mbeayou/Ball-and-Plate-Balancing-System/README.md

# Ball-and-Plate-Balancing-System
This is my graduation project done for the degree of Bachelor of Science in Electrical and
Electronic Engineering (specialization: Control system), it is about the modleing, design and control of a Ball and Plate Device. This device aims to stabalize a free ball on a plate and to cancel any disturbances that may destabelize the system, and to compare between the responses of different controllers (PID,MPC,LQR)

## Repository Structure
this repository contains:
* Full Arduino Code of the entire project.
* All simukation files with matlab and simulink files.
* Thesis documentation in Latex and in PDF.
* Presentation slides.
* images, video and other assits.

## mechanical and electrical form
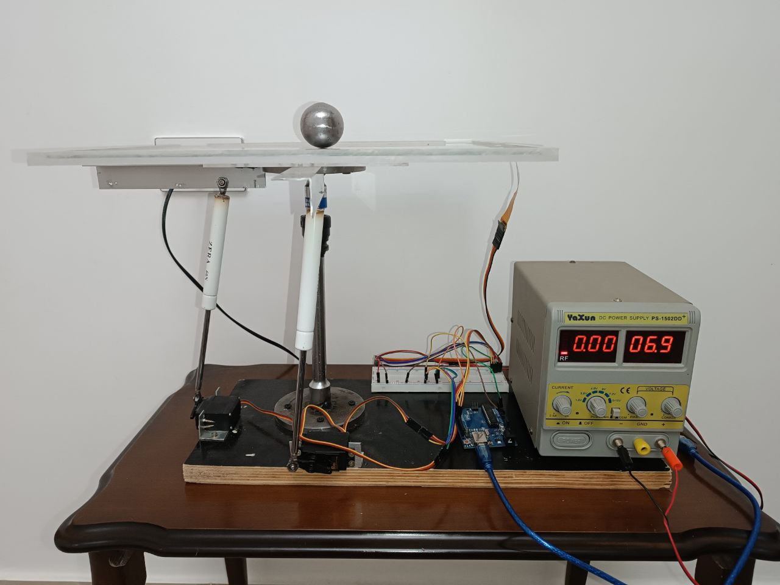
[picture p1: Assets/photo_2024-01-09_19-22-16.jpg]


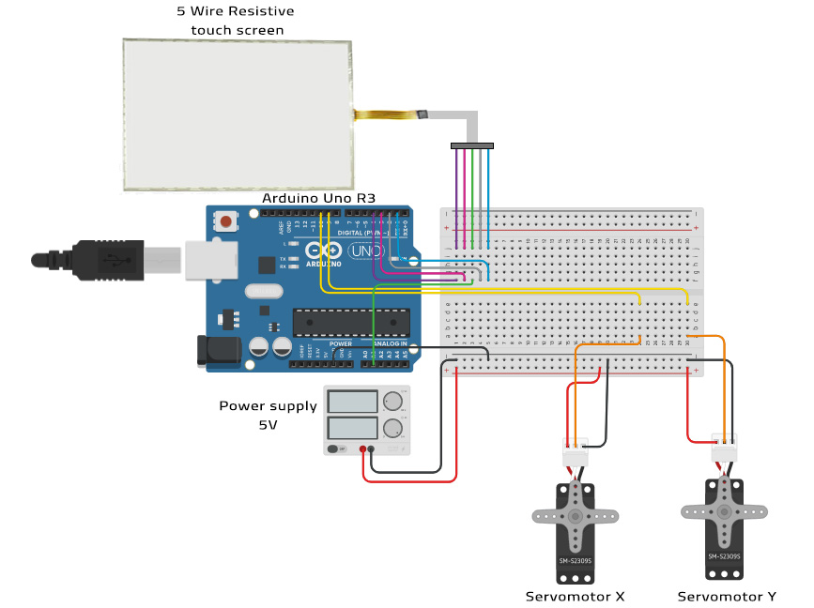
[picture p2: Documentation/Dissertation/Latex files/Figures/chapter02/Arduino_schematic.jpg]


## Acknowledgments
First of all, thanks to Allah for giving me the
ability, strength and aptitude to complete this
project.

I would like to extend my thanks and gratitude to
my supervisor Dr.Ali Elmelhi, for his advises,
suggestions, patience and encouragement
throughout this project.

I am deeply and forever obliged to thank my great
family for their love, caring, support and
encouragement throughout my entire life.

Finally, I would like to thank to all the good
friends that I have for their support and help,
with special appreciation for Mahmoud Karah
and Salman Ajweeli
