mbeayou/Ball-and-Plate-Balancing-System/Documentation/Dissertation/Latex files/titlepage.tex

\begin{titlepage}
\begin{center}
\begin{singlespace}

\vspace*{0.7cm}
\Large
Universty of Tripoli\\
Faculty of Engineering\\
Department of Electrical and Electronic Engineering \\
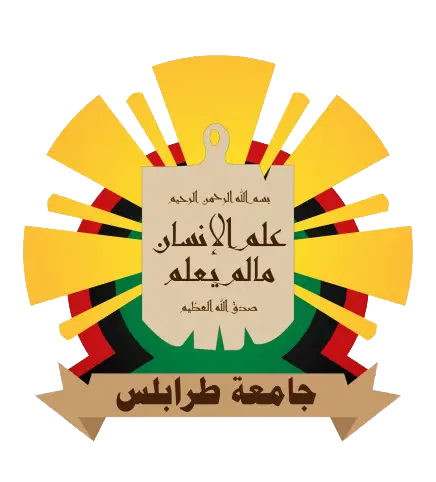
[picture p3: Documentation/Dissertation/Latex files/Figures/UOT_Logo.png]
            

\Huge
\textbf{Modeling, Control, and Experimental Validation of a Ball and Plate System}

\vspace{0.5cm}
\Large
A project submitted in partial fulfilment of the requirements for the
degree of Bachelor of Science in Electrical and Electronic Engineering

\vspace{1.2cm}
Prepared by:\\
\textbf{Mohammed S. Baayou}

\vspace{0.8cm}
Supervised by:\\
Dr. Ali S. ElMelhi
                   
\vspace{1cm}
\large
\textbf{Spring 2023}

\end{singlespace}            
\end{center}
\end{titlepage}
