mbeayou/Ball-and-Plate-Balancing-System/Documentation/Dissertation/Latex files/Chapters/appendixB.tex

\begin{figure}[h]
    \centering
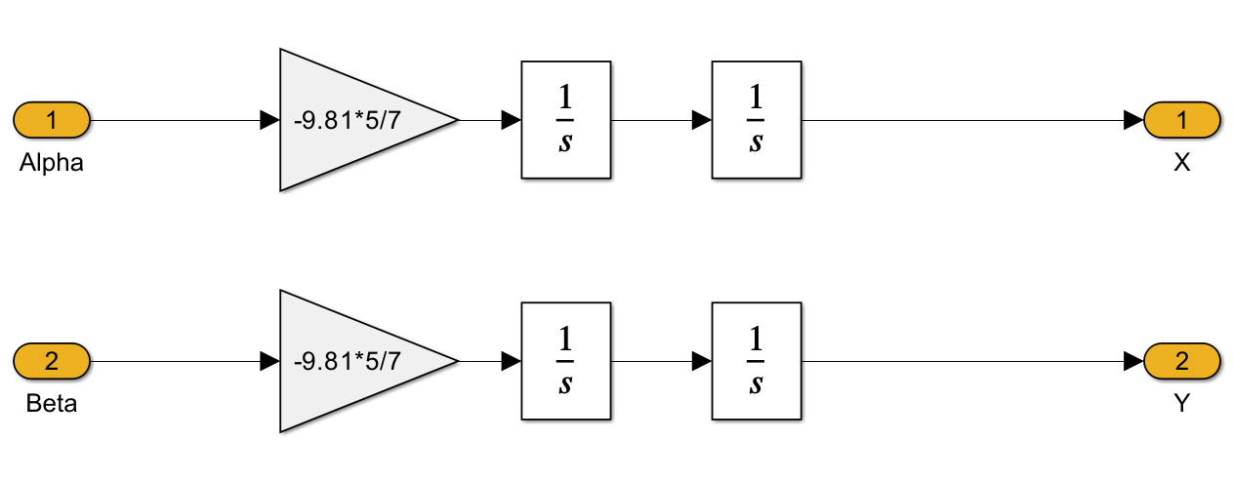
[picture p4: Documentation/Dissertation/Latex files/Figures/chapter03/Linear_BPS_Simulink_Model_inTransferFunction.jpg]
    
    \caption{Linear simulation model of the Ball and Plate System in a transfer function form}

\end{figure}
\begin{figure}
    \centering
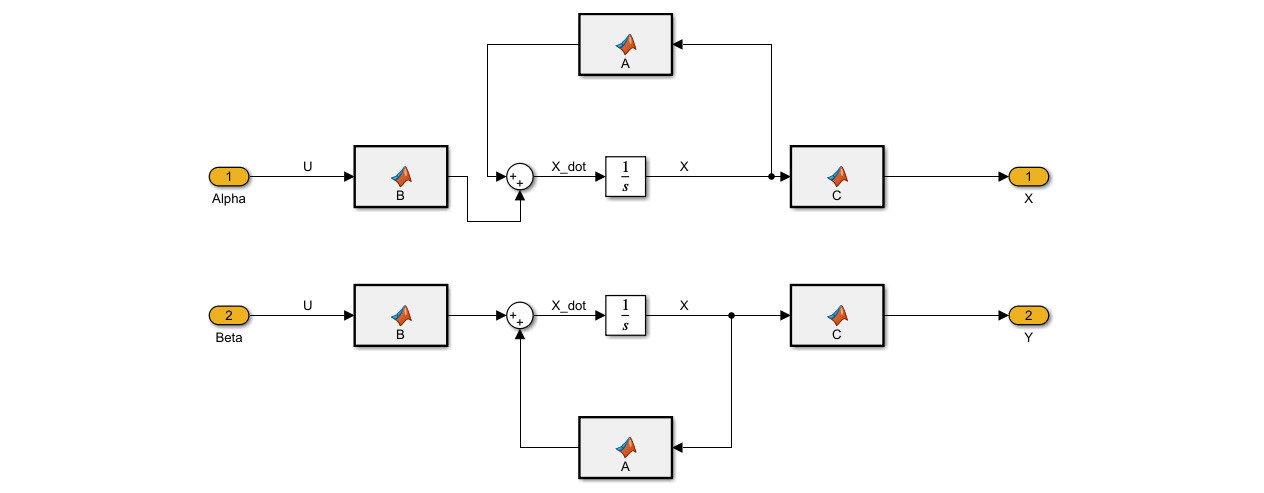
[picture p5: Documentation/Dissertation/Latex files/Figures/chapter03/Linear_BPS_Simulink_Model_inStateSpace.jpg]
    
    \caption{Linear simulation model of the Ball and Plate System in state-space form}
\end{figure}

\begin{sidewaysfigure}
\centering
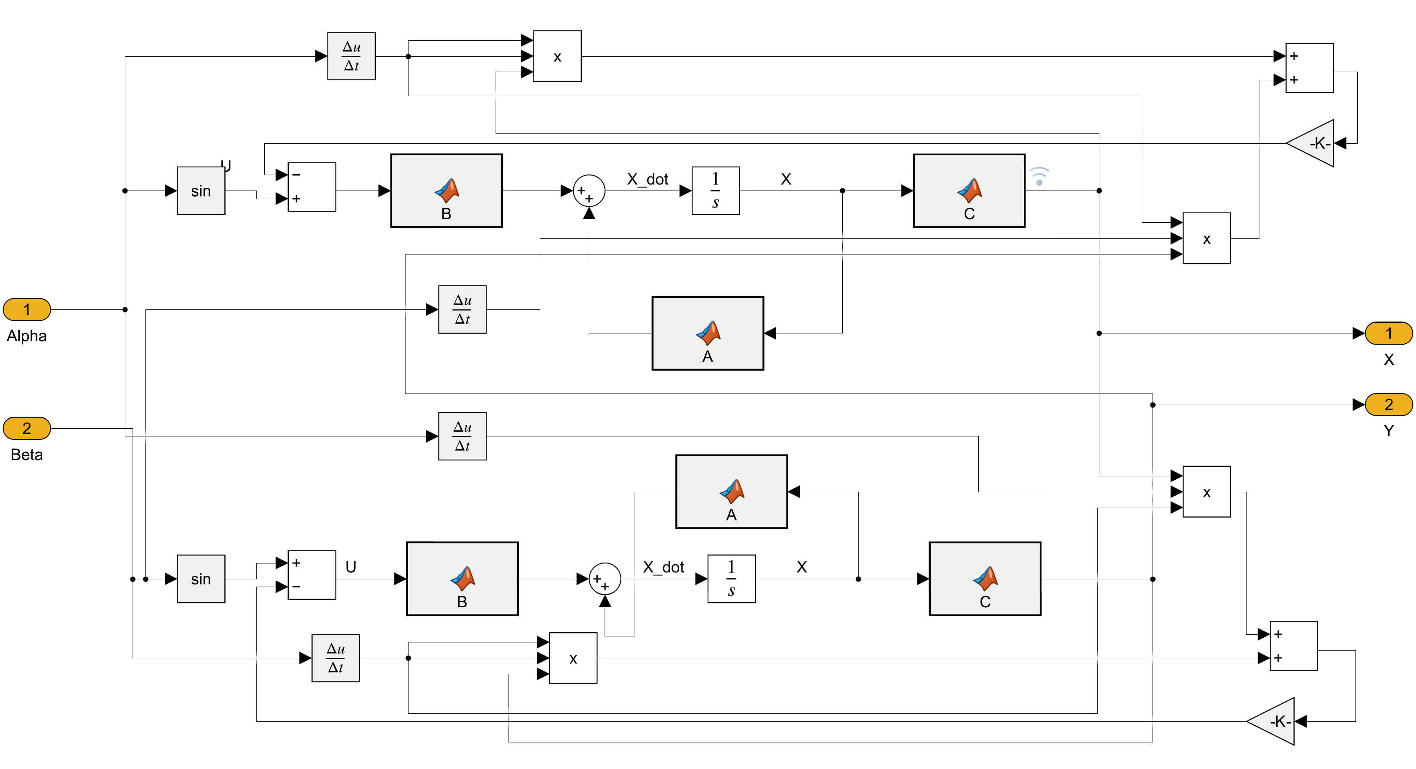
[picture p6: Documentation/Dissertation/Latex files/Figures/chapter03/nonlinear.png]

\caption{Approximated representation of the non-linear BPS dynamics in a Simulink model}
\label{fig:IMs matrix correlation}
\end{sidewaysfigure}

\begin{sidewaysfigure}
\centering
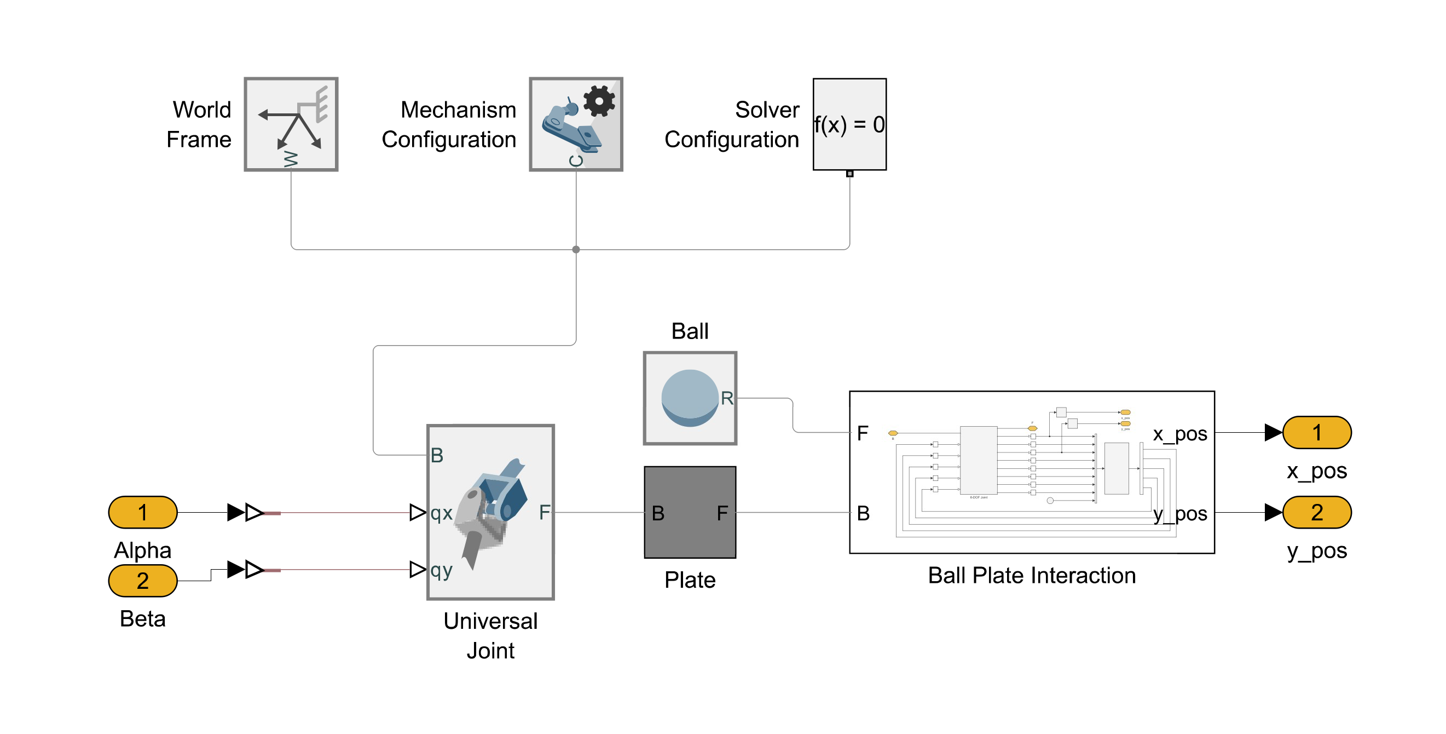
[picture p7: Documentation/Dissertation/Latex files/Figures/chapter03/simscape.png]

\caption{Dynamic simulation of the non-linear Ball and Plate System using Simscape}
\label{fig:IMs matrix correlation}
\end{sidewaysfigure}

\begin{sidewaysfigure}
\centering
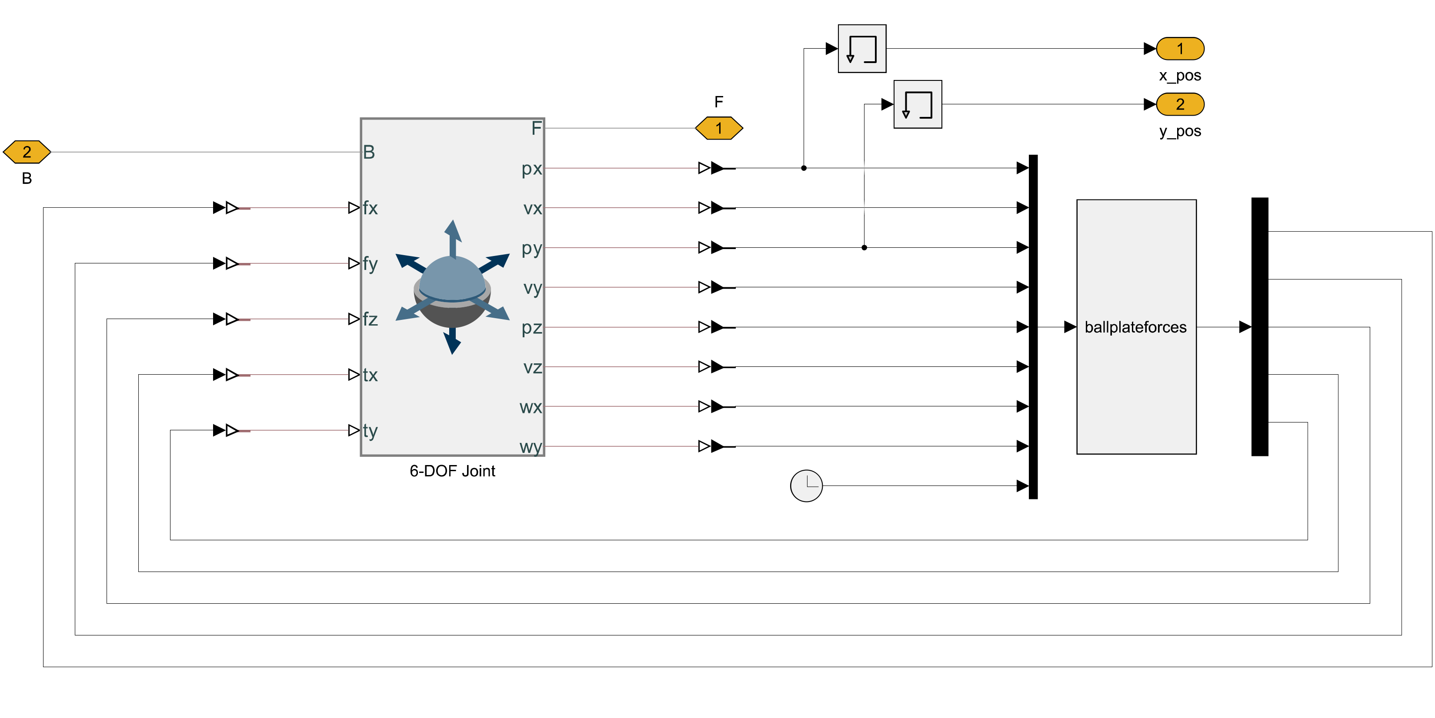
[picture p8: Documentation/Dissertation/Latex files/Figures/chapter03/BPinteration.png]

\caption{BPS interaction subsystem}
\label{fig:IMs matrix correlation}
\end{sidewaysfigure}

\begin{sidewaysfigure}
\centering
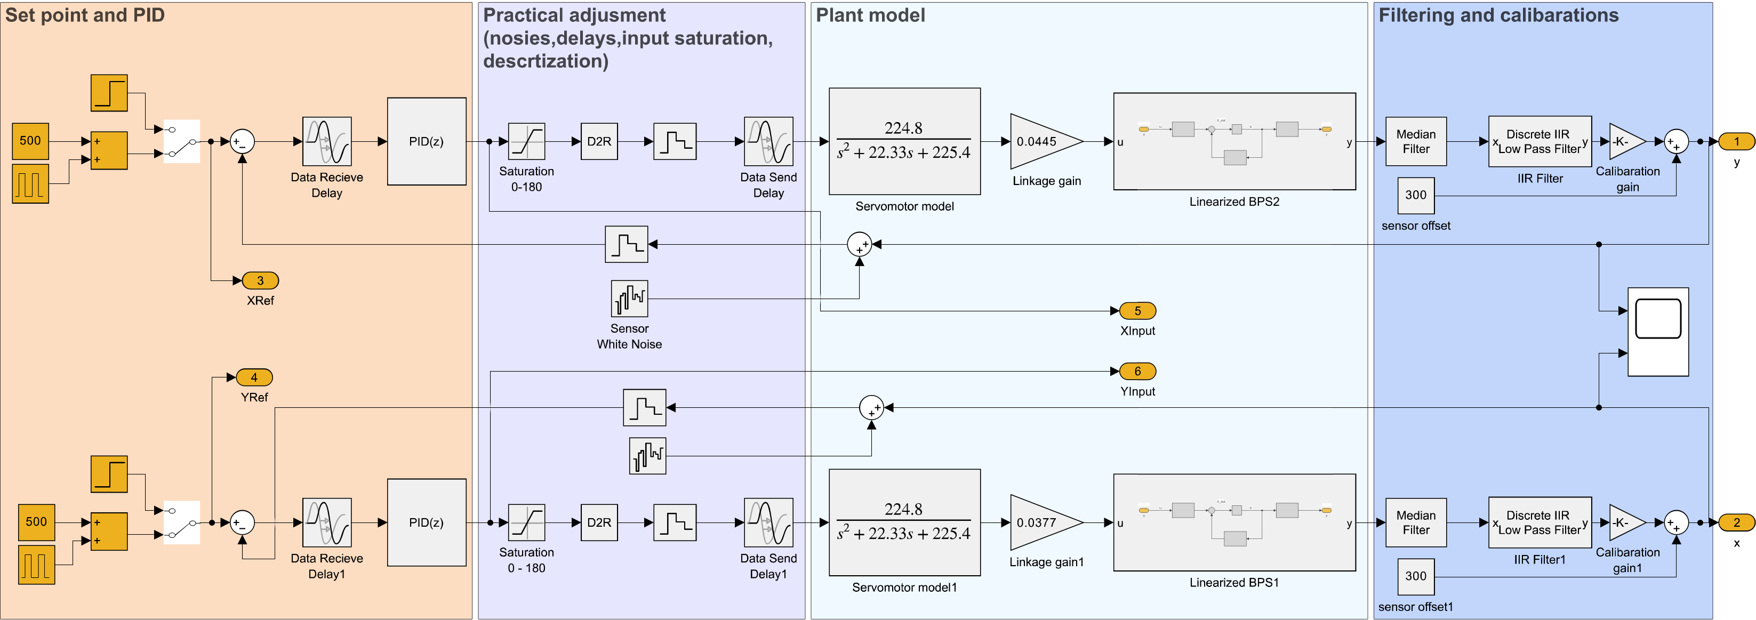
[picture p9: Documentation/Dissertation/Latex files/Figures/chapter04/practicalPID.png]

\caption{PID Simulink Model Illustrating Practical Adjustments: saturation, calibration, white noises, communication delays}
\label{fig:IMs matrix correlation}
\end{sidewaysfigure}

\begin{sidewaysfigure}
\centering
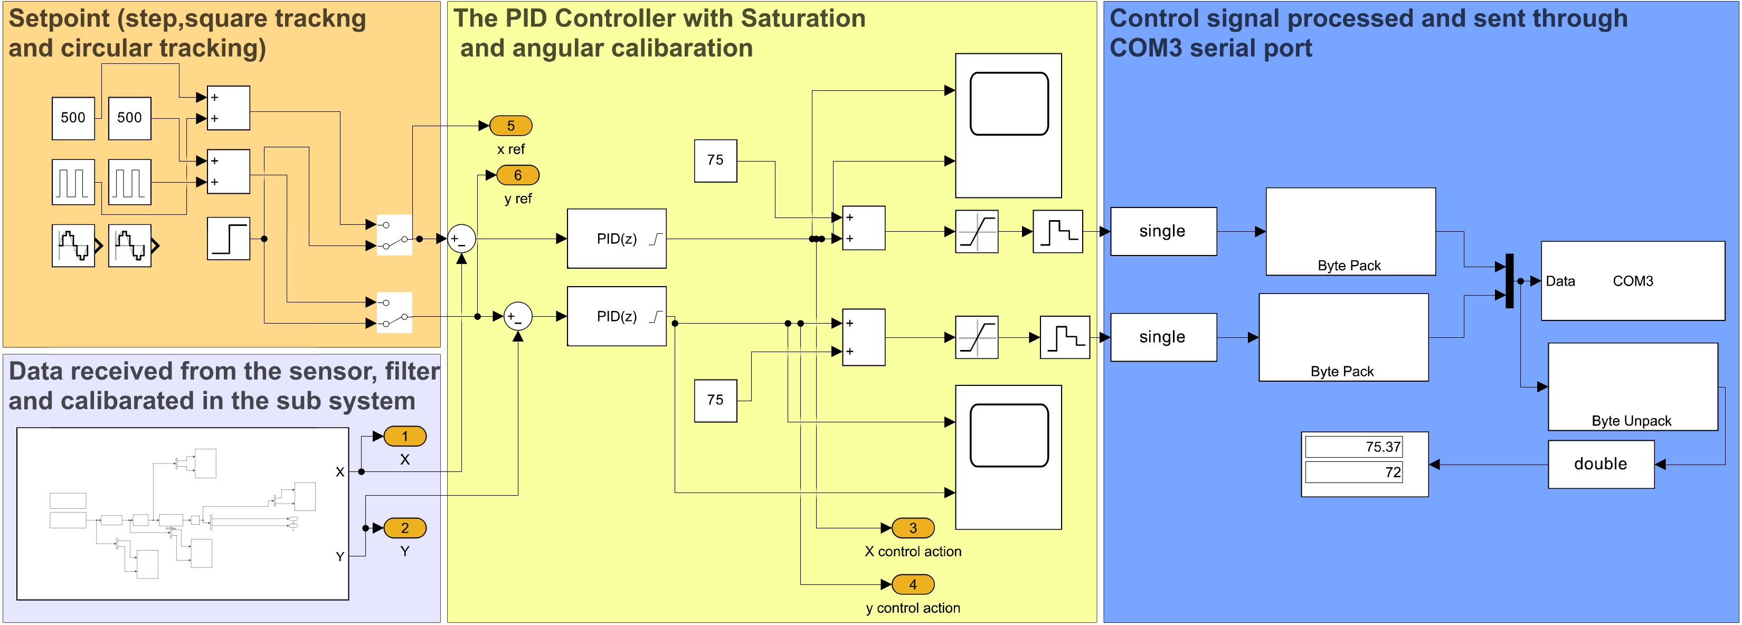
[picture p10: Documentation/Dissertation/Latex files/Figures/chapter04/simulink_real_system_pid_model.png]

\caption{Simulink Model used for Controlling the real system}
\label{fig:IMs matrix correlation}
\end{sidewaysfigure}

\begin{sidewaysfigure}
\centering
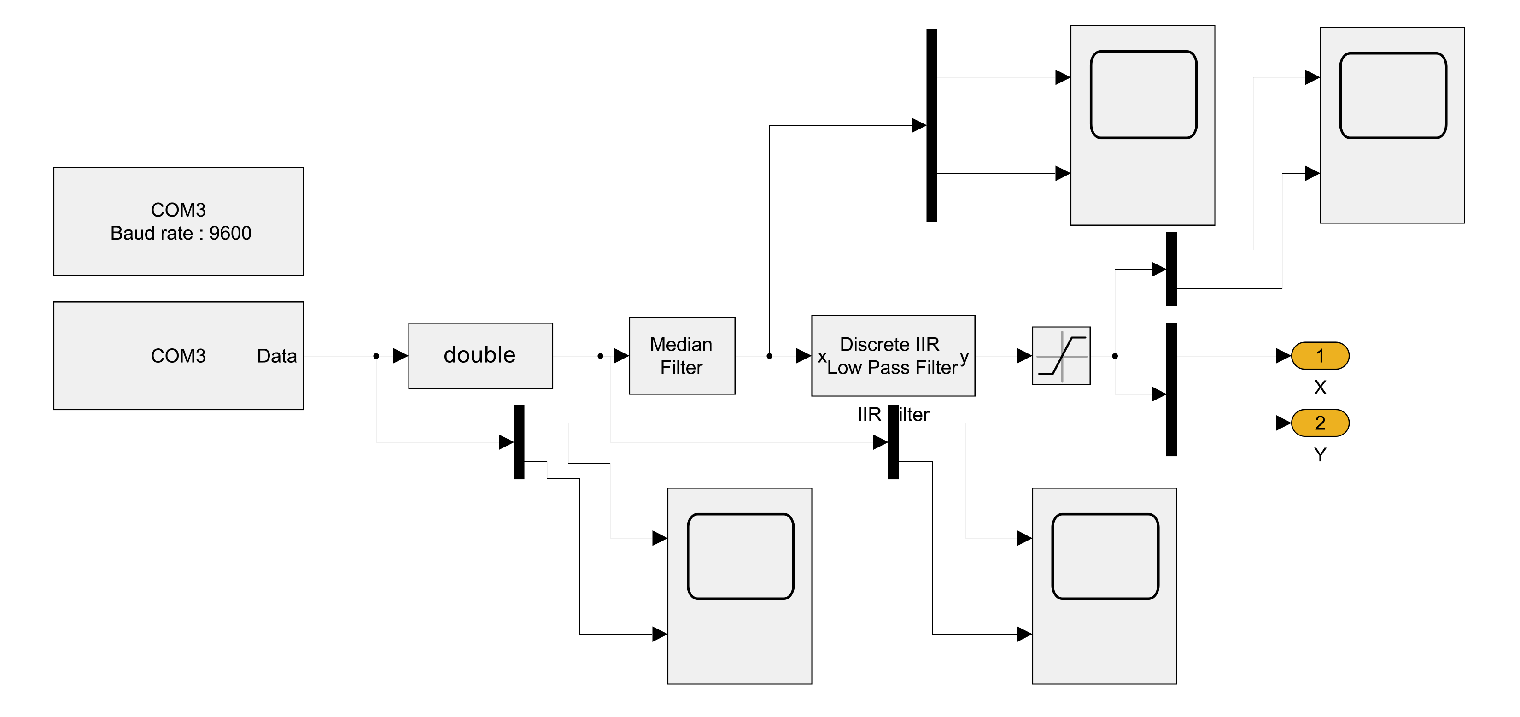
[picture p11: Documentation/Dissertation/Latex files/Figures/chapter04/simulink_real_system_pid_model_subsys.png]

\caption{Simulink Block used for receiving the feedback data}
\label{fig:IMs matrix correlation}
\end{sidewaysfigure}
