mbeayou/Ball-and-Plate-Balancing-System/Presentation/thesis2.pdf

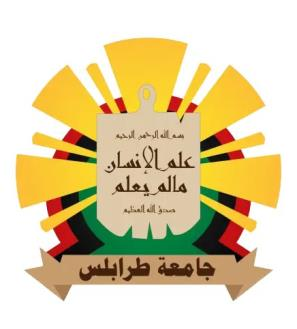
[picture p53: figure]
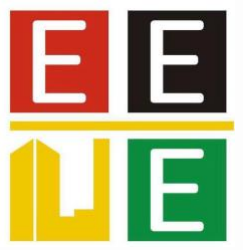
[picture p54: figure]

# Modeling, Control, and Experimental Validation of a Ball and Plate System

Prepared by: Mohammed S. Baayou
Supervised by: Dr. Ali S. ElMelhi

# Table of contents

Responses and results with discussion

A bierif overview and some motovations sights

PID controller tuning and
designing

Mechanical and electrical
parts and design

01

04 | 05

02

Conclusion
recommendations and
future work

Langrangian modeling and
linearization

06

03

### Introduction and Motivations

Control Design | Results Analysis Plant Selection and Implementation

### Conclusions

### Mathematical Modeling

# Introduction and Motivation

You can describe the topic of the section here

01

# System advantages

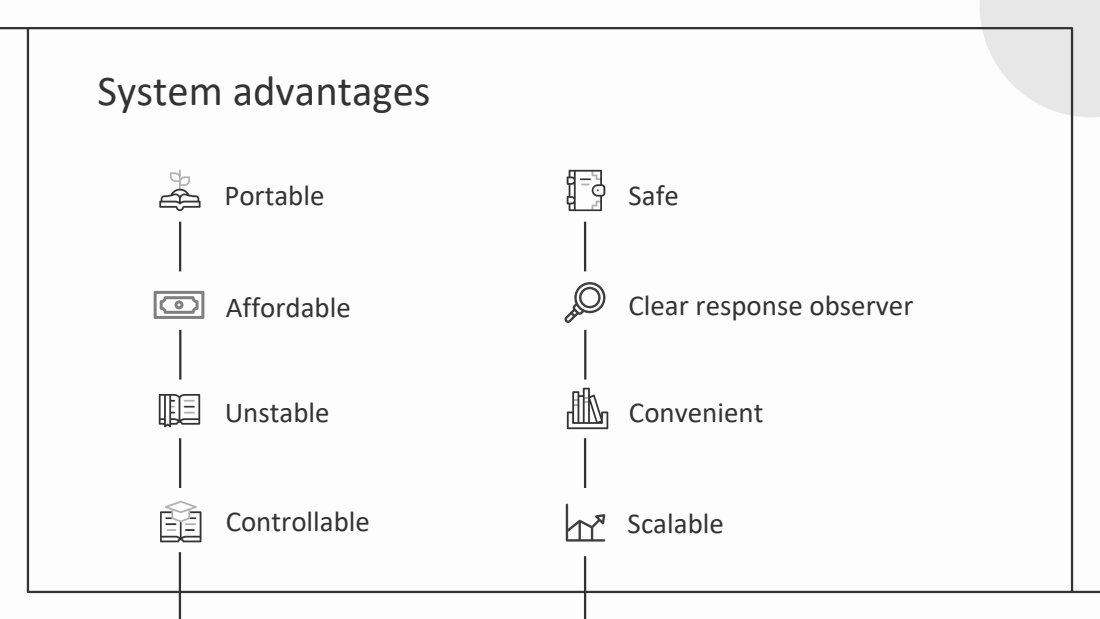
[picture p55: page 4]
Portable; Safe; Affordable; Unstable; Convenient; Controllable; Scalable

Clear response observer

# Plant Selection and Implementation

You can describe the topic of the section here

02

# Plant selection based on degree of freedom

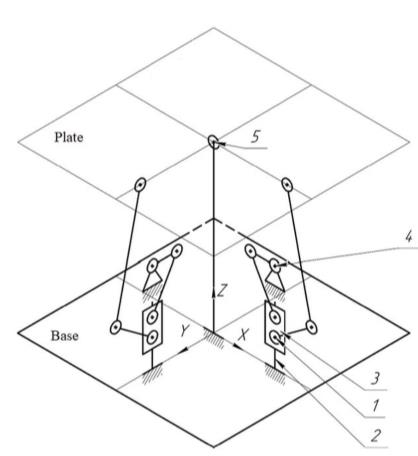
[picture p56: figure]
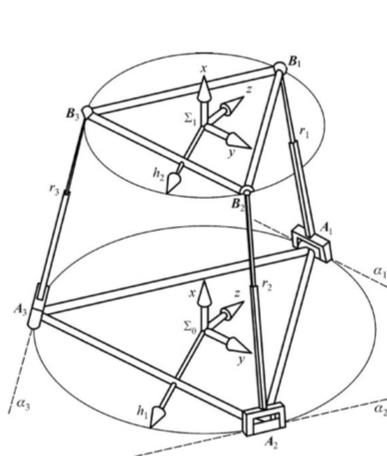
[picture p57: figure]
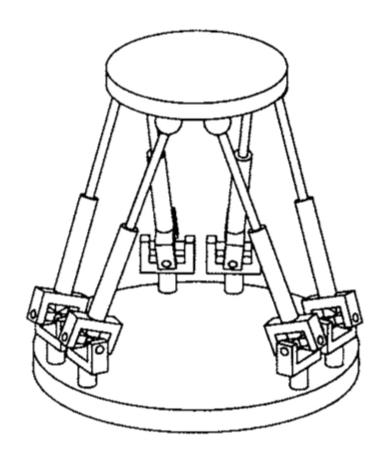
[picture p58: figure]

2 DOF | 3 DOF | 6 DOF

# Mechanical design

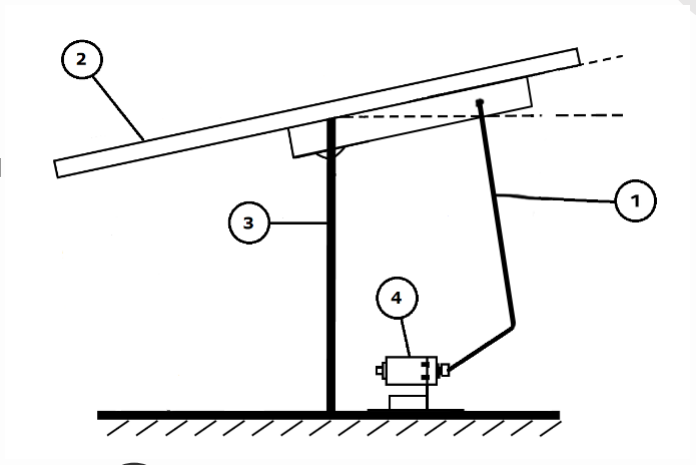
[picture p59: figure]

A linkage part between the actuator and the plate

Transparent plastic flat platform in 200mm x 2mm dimension

Pivotal connection allowing the plate to move around two axis

## Linkage Rods

## Plate

Base and Universal Joint | Actuator holder A simple aluminium structure that holds the actuator in place

1

2

3 | 4

# Electrical parts selection

- Camera
- Resistive touch screen
- Infrared sensor
- Servo motor
- Stepper motor
- DC motor
- Arduino
- PC via simulink
- PCB circuitry

## Electrical parts

Sensor

Actuator

Microcontroller

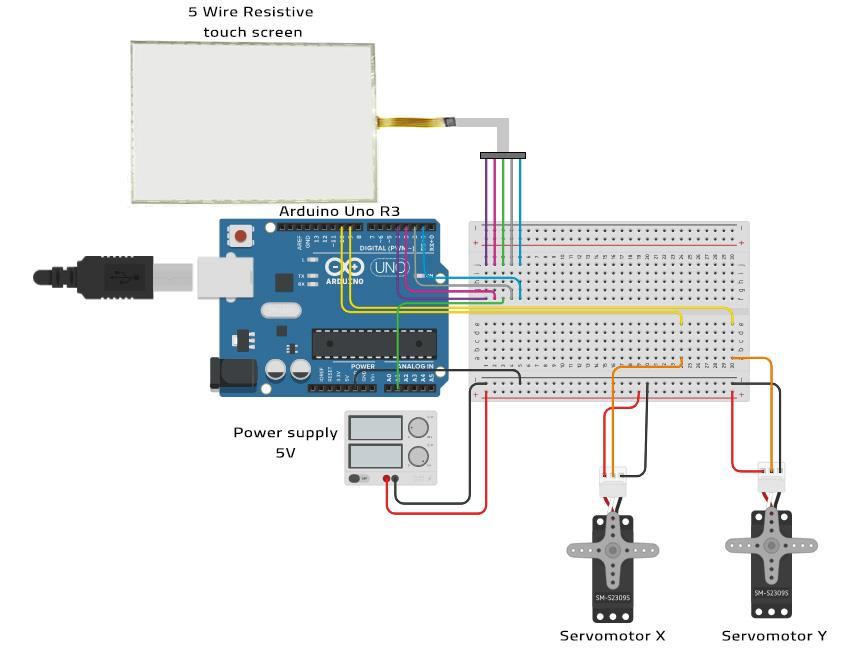
[picture p60: figure]

# Electrical connection

You can replace the images on the screen with your own work. Just right-click on them and select “Replace image”

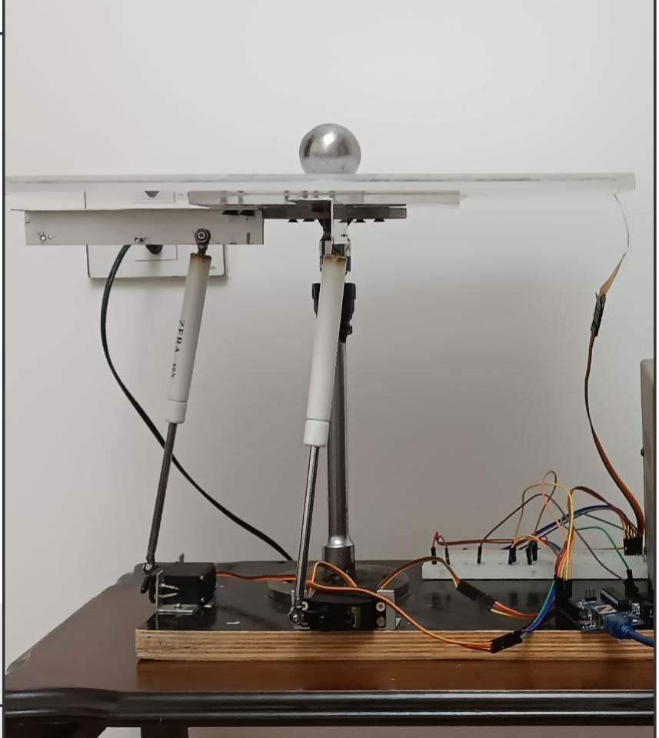
[picture p61: figure]

# The final form of the BPS system

This image reveal the final appearance of the system with a steel ball resting on top of it

# Mathematical Modeling

In this section the mathimatical of servo and BPS and linearization efforts will be disscussed

03

# The system is divided into:

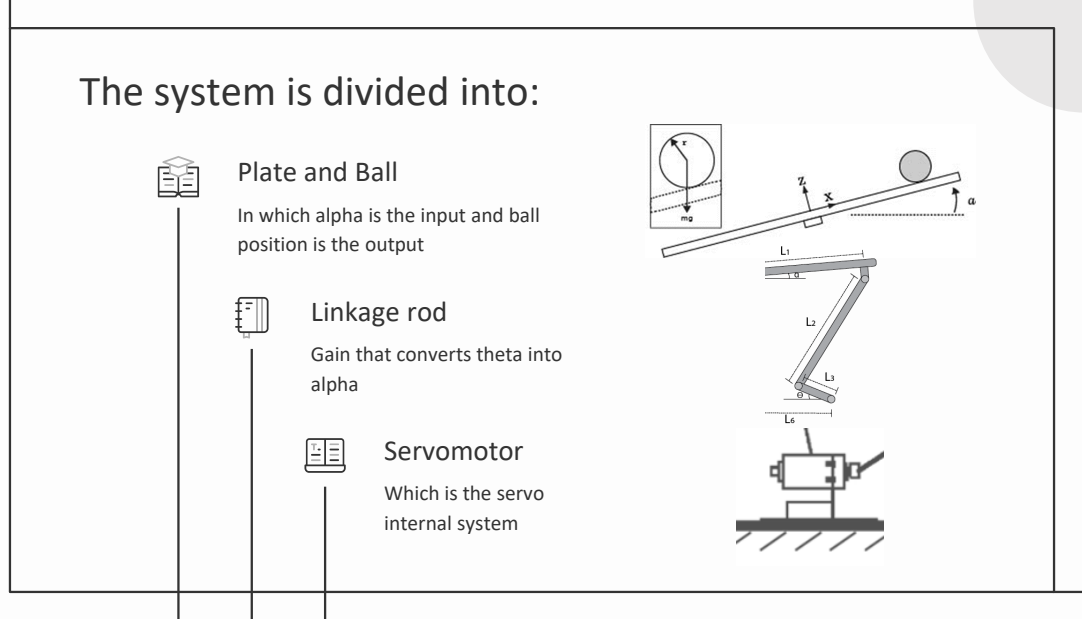
[picture p62: page 12]
Linkage rod; Servomotor

Plate and Ball

In which alpha is the input and ball
position is the output

Gain that converts theta into
alpha

Which is the servo
internal system

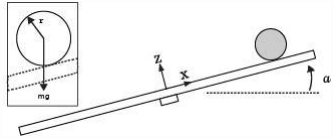
[picture p63: figure]

# Assumptions

- All friction forces are neglected
- the ball is symetric and rounded
- The plate has infinite surface

d
dt

dL

# dqሶ

−

dL
dq

= Q

# Euler Lagrange Formula

# Kinetic and potential

# energy

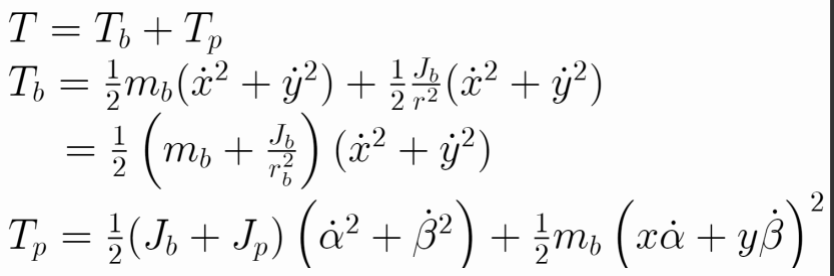
[picture p64: figure]

# Equation of motion

Differential equations | In state space

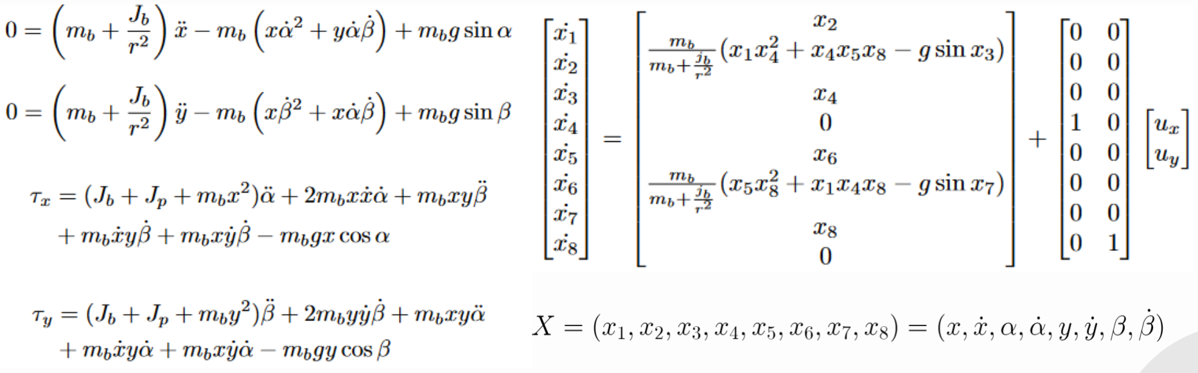
[picture p65: figure]

# Simplification and linearization

Simplification assumption | Linearized model

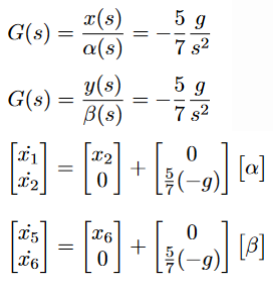
[picture p66: figure]

- The inclination angles assumed to be
small < 15 therefore sine(ɑ) = ɑ
- The motor doesn’t lose any steps and load doesn’t affect their performance
- The ball is solid spherical object

Linkge gain | Servo

motor
angle

Inclinatio
n angle
alpha

Inclinatio
n angle
beta
0 | -7.9 | 7.3
5 | -7.8 | 7.0
10 | -7.6 | 6.8
15 | -7.2 | 6.6
85 | 0.8 | -1.7
90 | 1.3 | -2.3
95 | 2.0 | -2.9
| …….
145 | 9.0 | -9.0
150 | 9.6 | -9.3
180 | 10.5 | -10.2

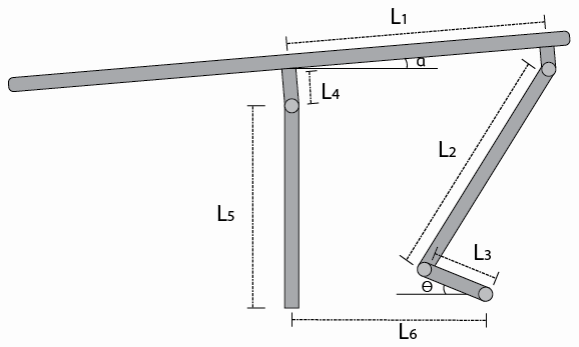
[picture p67: figure]

Mapping the angles and using linear polynomial regression:

Kx = 0.0445 Ky = 0.0377

Mapping table

# Servomotor

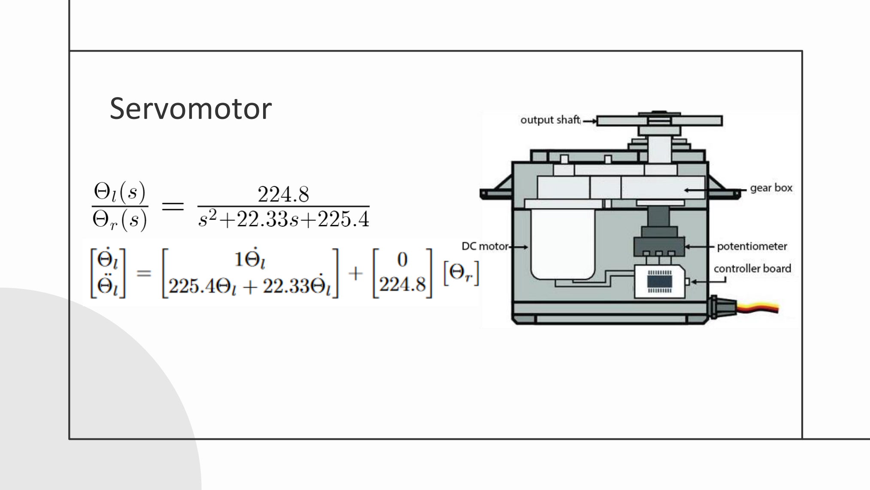
[picture p68: page 19]

# Overall model

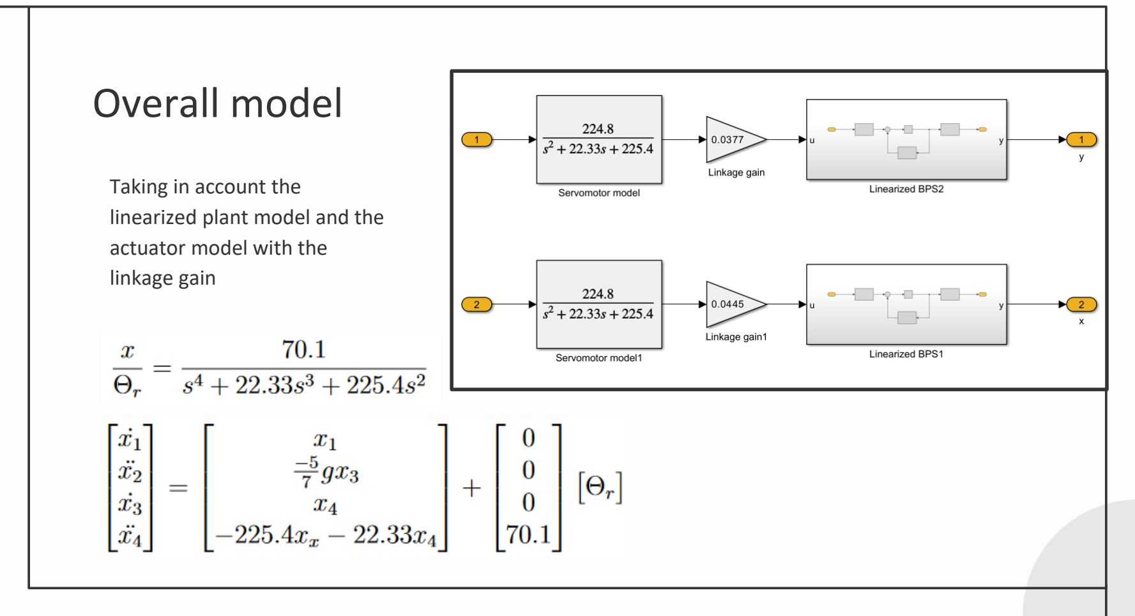
[picture p69: page 20]

Taking in account the
linearized plant model and the actuator model with the
linkage gain

# Control Design and Challenges

You can describe the topic of the section here

04

# Control Requirements

- the plate to incline only in 15 deg in both coordinates.
- Settling time: less than 5 seconds
- Rise time: less than 1 seconds
- Overshoot: less than 20%
- Steady state error: less than 0.1%

# Designing steps

01 | 02 | 03

## Simulation

| Simulink modeling and tuning

## Experimental

| | Implementation and testing via simulink and arduino

## Analyzing

Controllability check,
Rootlocus analysis

# Root locus with no controller

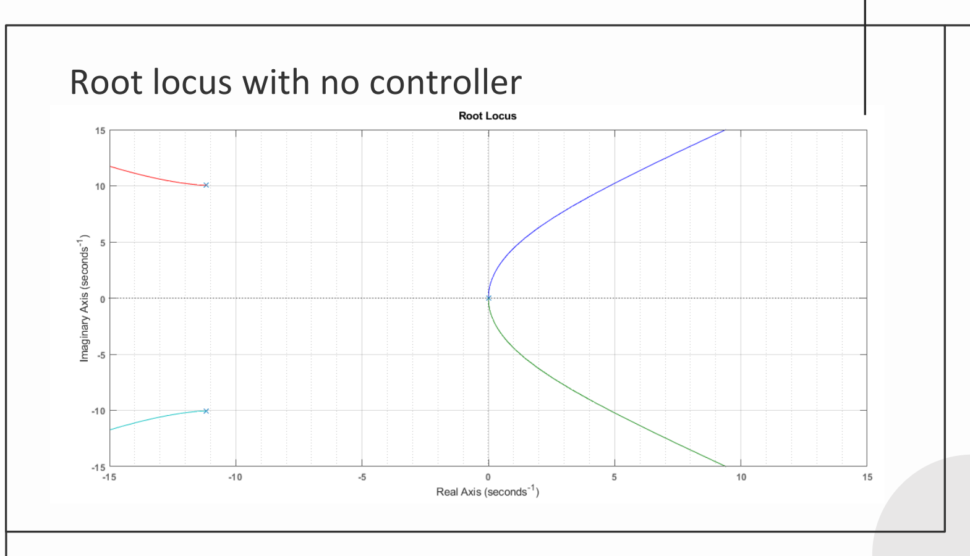
[picture p70: page 24]

# Continuous time Simulink model for PID controller

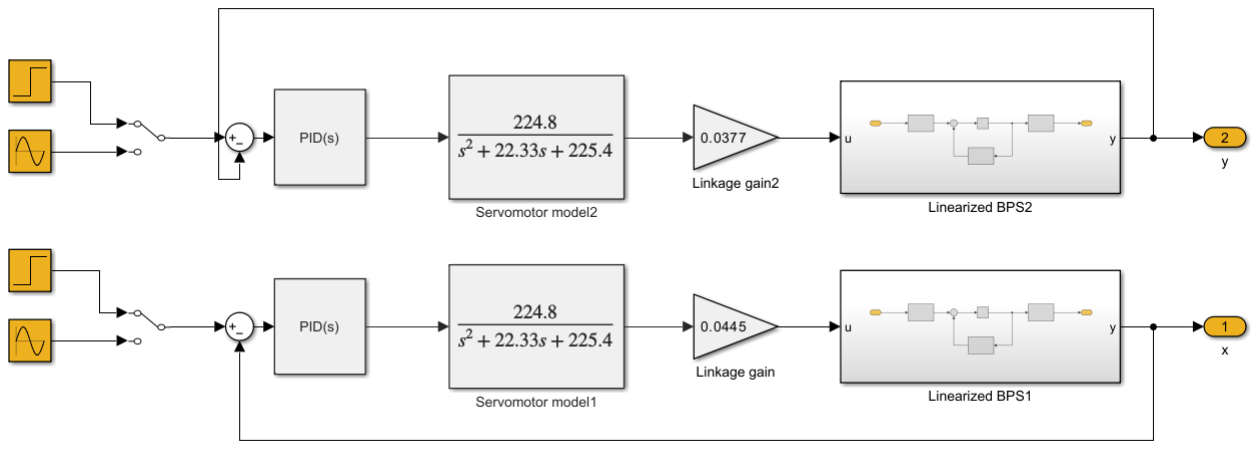
[picture p71: figure]

# Discrete simulink model with practical adjustment PID

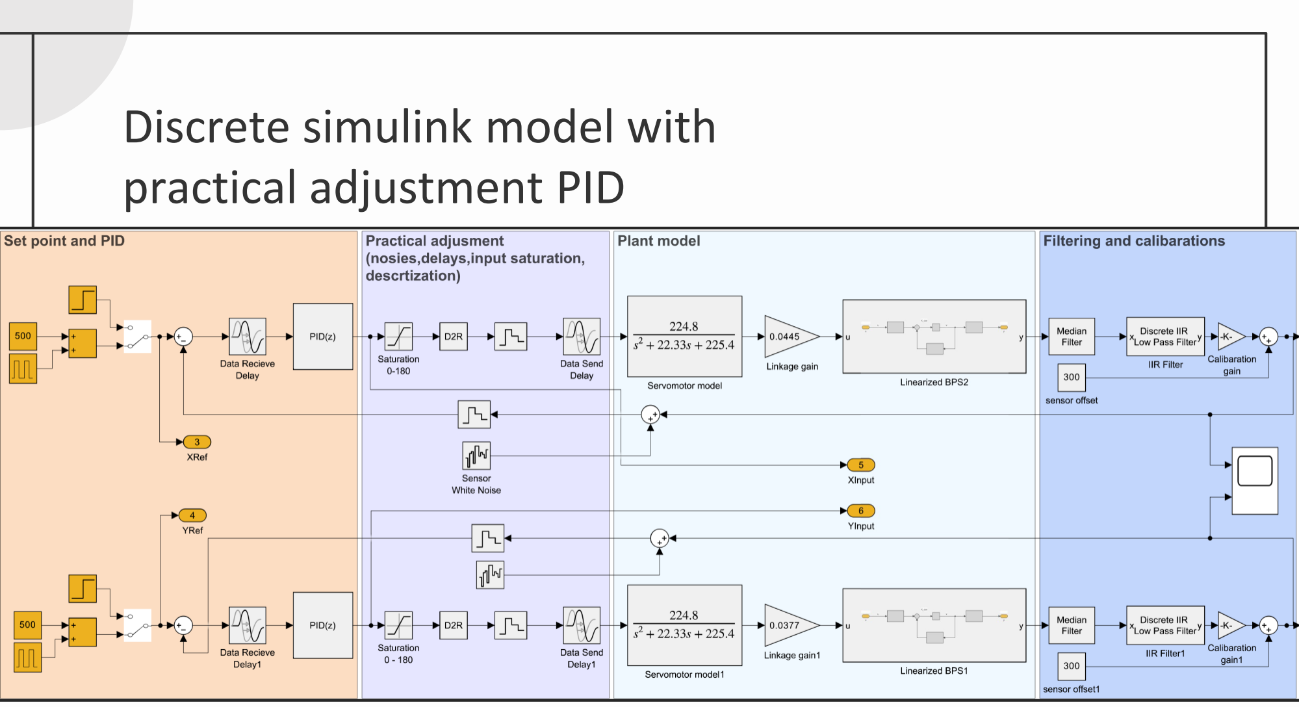
[picture p72: page 26]

# Tuned PID parameters

| Prpotional gain | Integral gain | Derivative gain
PID X 1 | 0.125 | 0.00184 | 0.098
PID Y 1 | 0.127 | 0.00084 | 0.088
PID X 2 | 0.165 | 0.00085 | 0.11
PID Y 2 | 0.167 | 0.00084 | 0.105
PID X 3 | 0.105 | 0.00084 | 0.07
PID Y 3 | 0.107 | 0.00184 | 0.069

# Simulink model with practical adjustment PID

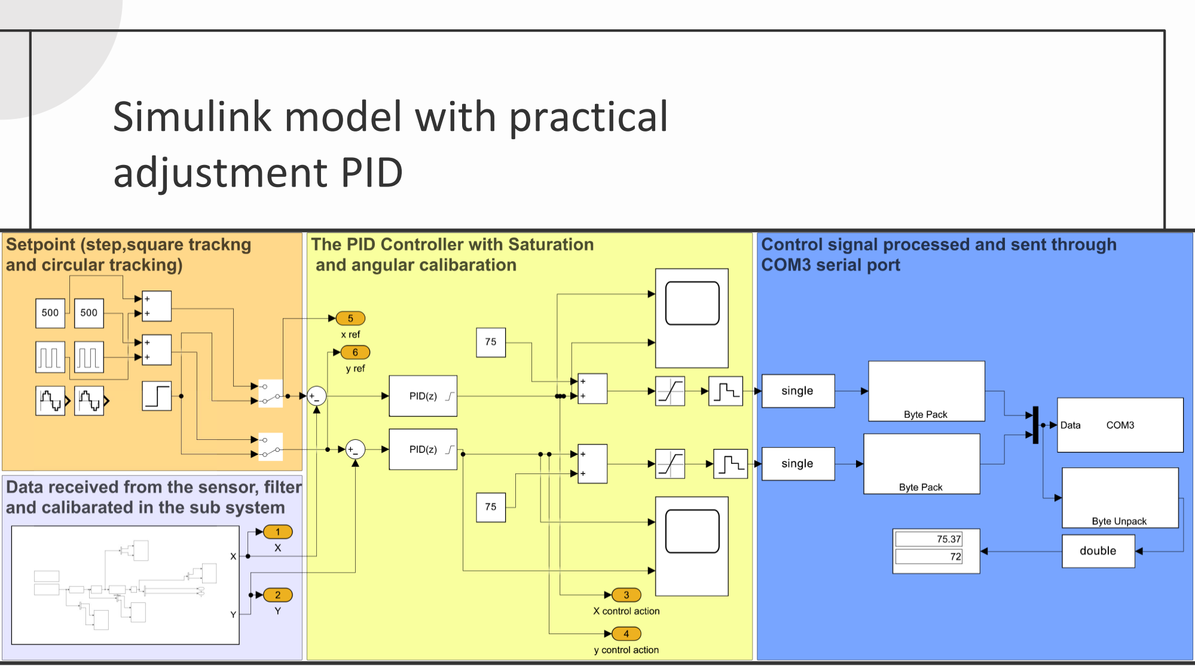
[picture p73: page 28]

# Challenges and limitation

To eliminate signal noises 3 filters was applied:
- Arduino code detect when a touch happen
- Athematic median filter with 3 windows size
- Low pass filter

## Sensor noises and filtering delay

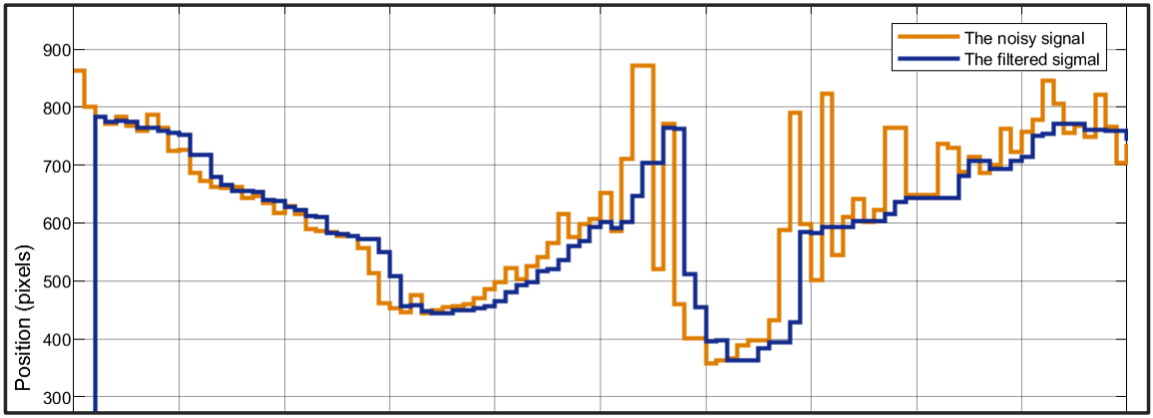
[picture p74: figure]

# Challenges and limitation

To connect arduino with matlab serial communication was used, this may cause a transpotation delay

## Connecting Arduino with Matlab

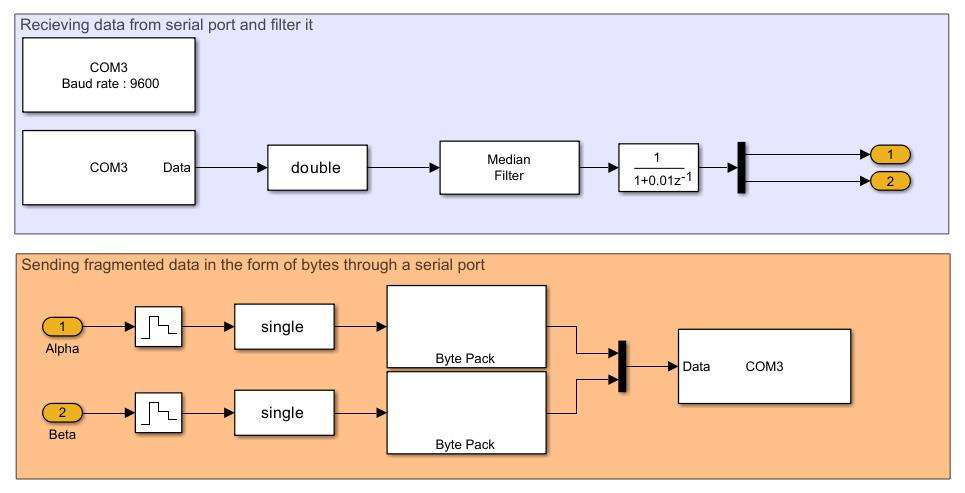
[picture p75: figure]

# Challenges and limitation

The suddenly changes in setpoint or the input make an undesired phenomenon called Derivative kicks

## Derivative kicks and noises degradation

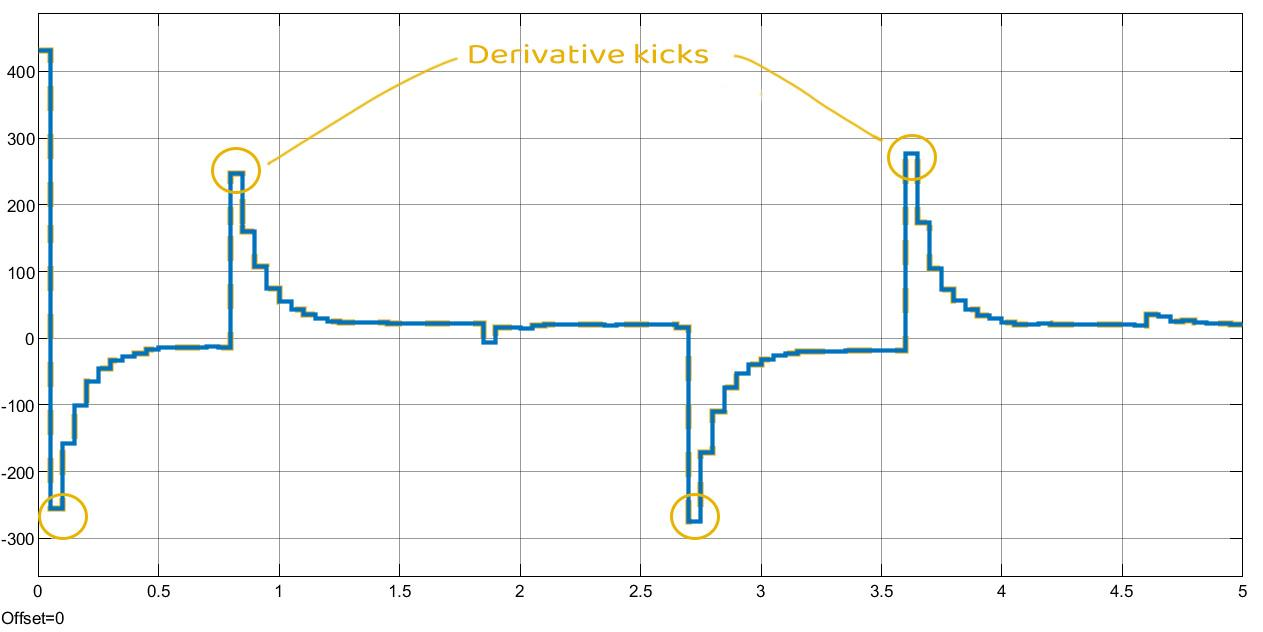
[picture p76: figure]

# Validation and Results

You can describe the topic of the section here

05

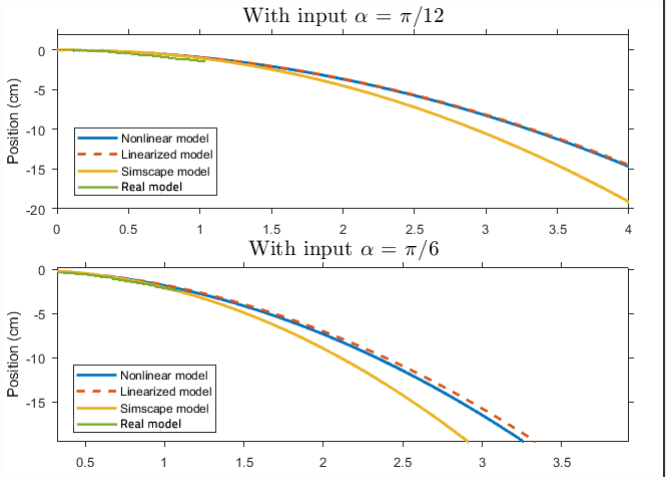
[picture p77: figure]

# Validation of modeling and linearization

# Experimental response and control action

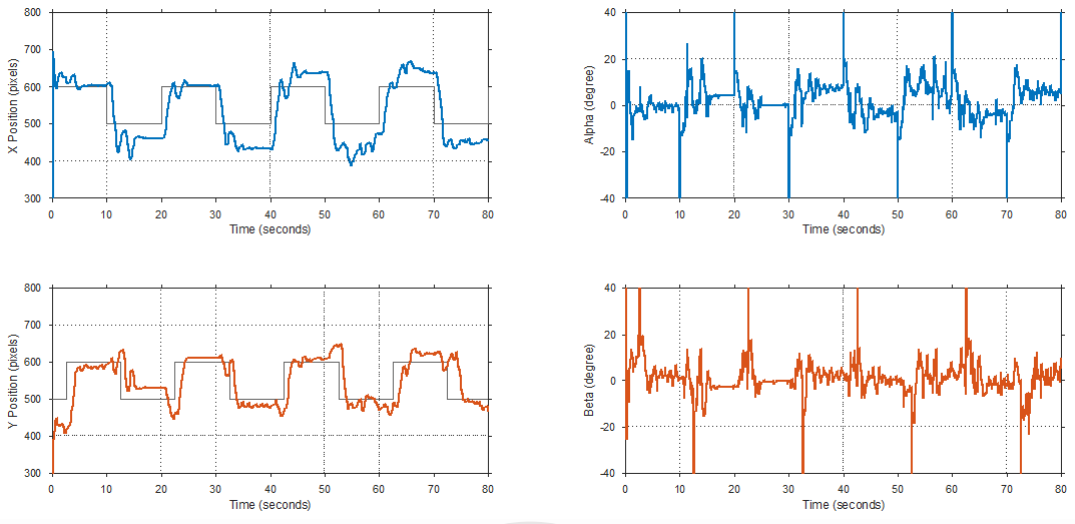
[picture p78: figure]

# Simulation response and control action


# Conclusions and Recommendations

You can describe the topic of the section here

06

# Conclusions

- Venus has a beautiful name and is the second planet from the Sun. It’s terribly hot—even hotter than Mercury
- Saturn is a gas giant and has several rings. This planet is composed mostly of hydrogen and helium
- Earth is the third planet from the Sun and the only one that harbors life in the Solar System
- Mercury is
- Jupiter is a gas giant, the biggest planet in the Solar System and the fourth-brightest object in the night sky
- Neptune is the farthest planet from the Sun. It's also the fourth-largest planet by diameter in the Solar System

# Thanks!

Do you have any questions?

# Purpose statement

Mercury is the closest planet to the Sun and the smallest one in the Solar System. The planet’s name has nothing to do with the liquid metal

Venus has a beautiful name and is the second planet from the Sun. It’s terribly hot and its atmosphere is extremely poisonous

Jupiter is a gas giant and the biggest planet in the Solar System. It's the fourth-brightest object in the sky. It was named after a Roman god

## What about Mercury?

## What about Venus?

## What about Jupiter?

# “This is a quote. Words full of wisdom that someone important said and can make the reader get inspired”

# —Someone Famous

98,300,000

Big numbers catch your audience’s attention

Jupiter's rotation period

# 9h 55m 23s

333,000

The Sun’s mass compared to Earth’s
386,000 km

Distance between Earth and the Moon

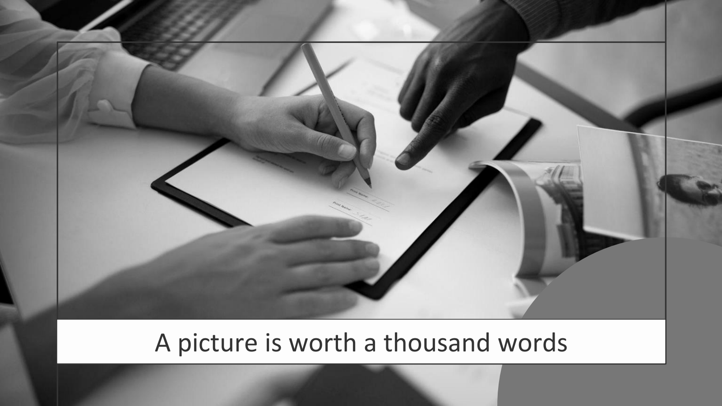
[picture p79: page 44]

# A picture is worth a thousand words

# A picture is worth a thousand words

# Thanks!

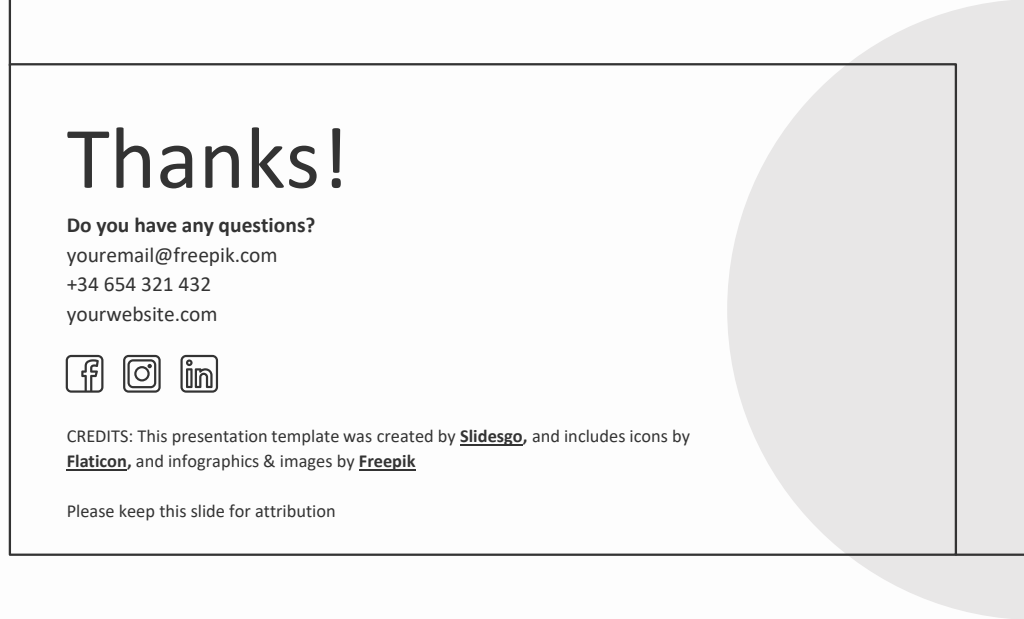
[picture p80: page 46]

Do you have any questions?
youremail@freepik.com
yourwebsite.com

CREDITS: This presentation template was created by Slidesgo, (https://bit.ly/3A1uf1Q) and includes icons by
Flaticon, (http://bit.ly/2TyoMsr) and infographics & images by Freepik (http://bit.ly/2TtBDfr)

Please keep this slide for attribution

# Current situation & problems statement

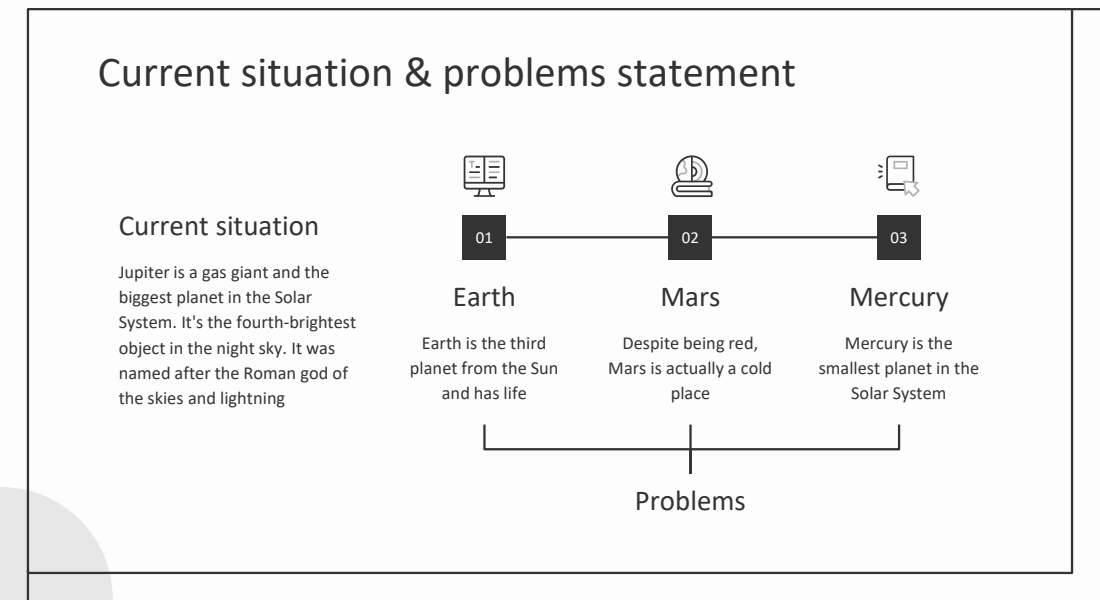
[picture p81: page 47]
Current situation; Earth; Mars; place; Mercury; Problems

Jupiter is a gas giant and the
biggest planet in the Solar
System. It's the fourth-brightest
object in the night sky. It was
named after the Roman god of
the skies and lightning

Earth is the third
planet from the Sun
and has life

Despite being red,
Mars is actually a cold

Mercury is the
smallest planet in the
Solar System

# Hypotheses

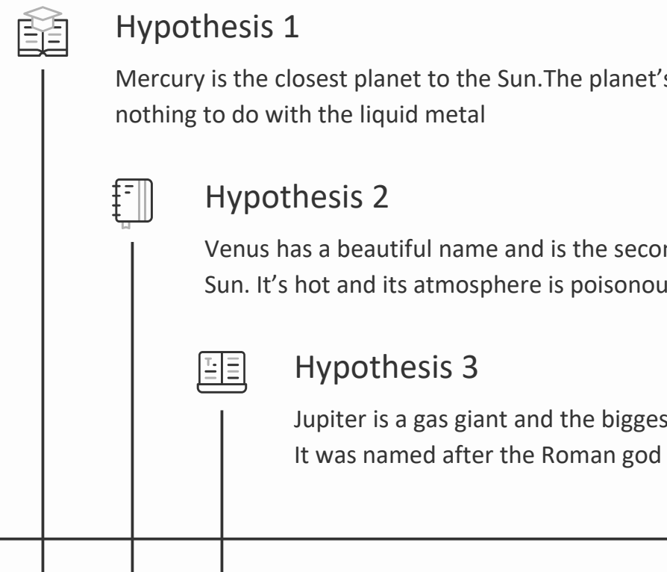
[picture p82: figure]
nothing to do with the liquid metal; It was named after the Roman god; Hypothesis 1; Hypothesis 2; Hypothesis 3

Mercury is the closest planet to the Sun.The planet’s name has

Venus has a beautiful name and is the second planet from the Sun. It’s hot and its atmosphere is poisonous

Jupiter is a gas giant and the biggest planet in the Solar System.

# Reviewing concepts is a good idea

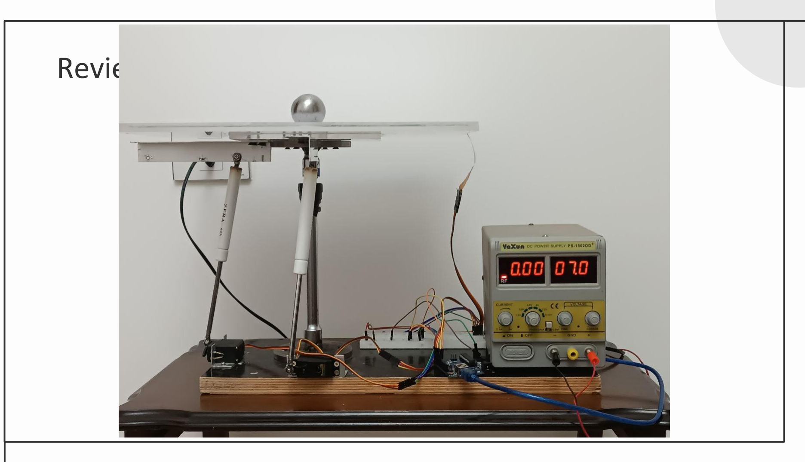
[picture p83: page 49]

# Reviewing concepts is a good idea

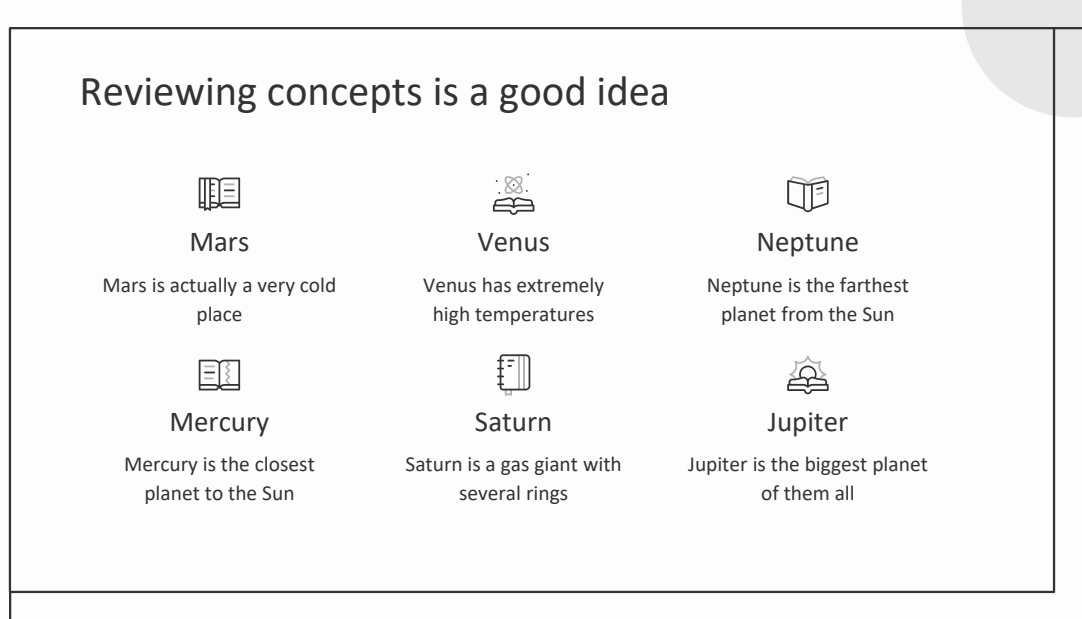
[picture p84: page 50]
place; Mercury; Mars; Venus; Neptune; Saturn; Jupiter

Mars is actually a very cold

Venus has extremely
high temperatures

Neptune is the farthest
planet from the Sun

Mercury is the closest
planet to the Sun

Saturn is a gas giant with
several rings

Jupiter is the biggest planet

of them all

# Literature review

- AUTHOR. (YEAR). Title of the publication. Publisher
- Mercury is the closest planet to the Sun and the smallest one
- AUTHOR. (YEAR). Title of the publication. Publisher
- Mars is full of iron oxide dust, which gives the planet its reddish cast
- AUTHOR. (YEAR). Title of the publication. Publisher
- Jupiter is a gas giant and the biggest planet in the Solar System
- AUTHOR. (YEAR). Title of the publication. Publisher
- Venus has a beautiful name and is the second planet from the Sun
- AUTHOR. (YEAR). Title of the publication. Publisher
- Earth is the third planet from the Sun and harbors life

# Theoretical framework

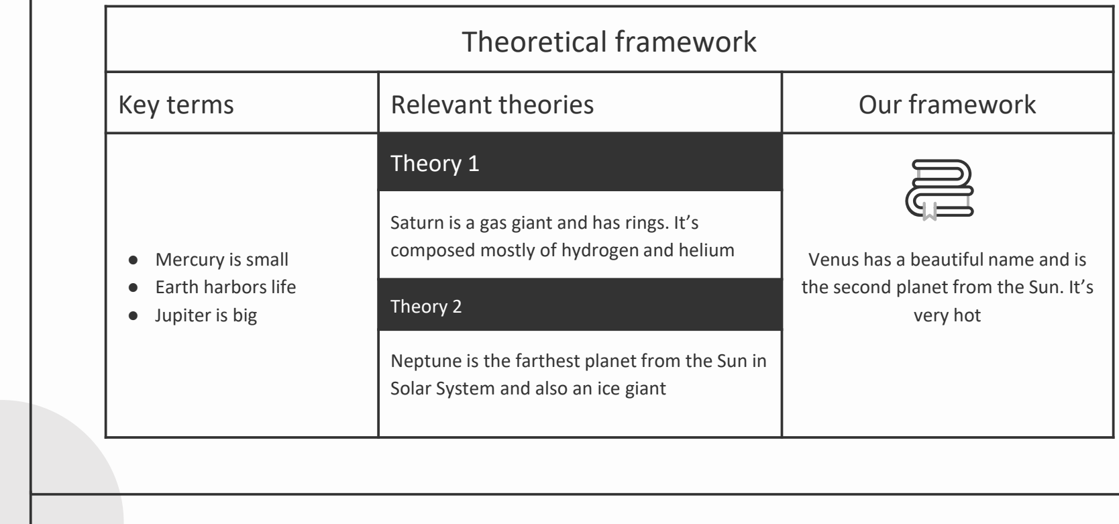
[picture p85: figure]
Theoretical framework; ● Mercury is small ● Earth harbors life ● Jupiter is big; Theory 1; Venus has a beautiful name and is the second planet from the Sun. It’s very hot; composed mostly of hydrogen and helium; Theory 2; Solar System and also an ice giant

Key terms | Relevant theories | Our framework

Saturn is a gas giant and has rings. It’s

Neptune is the farthest planet from the Sun in

# Schedule

Task | Description | Date | J | F | M | A | M | J | Status
Task 1 | Despite being red, Mars is cold | Jan 1 - Feb 15 | | | | | | | Completed
Task 2 | Earth is the planet with life | Feb 1 - Apr 30 | | | | | | | In progress
Task 3 | Venus has a beautiful name | Mar 15 - Apr 30 | | | | | | | Delayed
Task 4 | Neptune is far away from us | Apr 20 - May 15 | | | | | | | Unstarted
Task 5 | Jupiter is a huge gas giant | Jun 4 - Jun 30 | | | | | | | Unstarted

# Methodology

Mercury is the closest planet to the Sun and the smallest one

Venus has a beautiful name and is the second planet from the Sun

Mars is full of iron oxide dust, which gives the planet its reddish cast

Jupiter is a gas giant and the biggest planet in the Solar System

## Mercury

Type of data

Motives

Data collection

Sampling

# Analysis & development

- Venus has a beautiful name and is the second planet from the Sun. It’s terribly hot—even hotter than Mercury
- Saturn is a gas giant and has several rings. This planet is composed mostly of hydrogen and helium
- Earth is the third planet from the Sun and the only one that harbors life in the Solar System
- Mercury is the closest planet to the Sun and the smallest one in the Solar System—it’s a bit larger than the Moon
- Jupiter is a gas giant, the biggest planet in the Solar System and the fourth-brightest object in the night sky
- Neptune is the farthest planet from the Sun. It's also the fourth-largest planet by diameter in the Solar System
Phase 01 | Phase 02

# Analysis & development

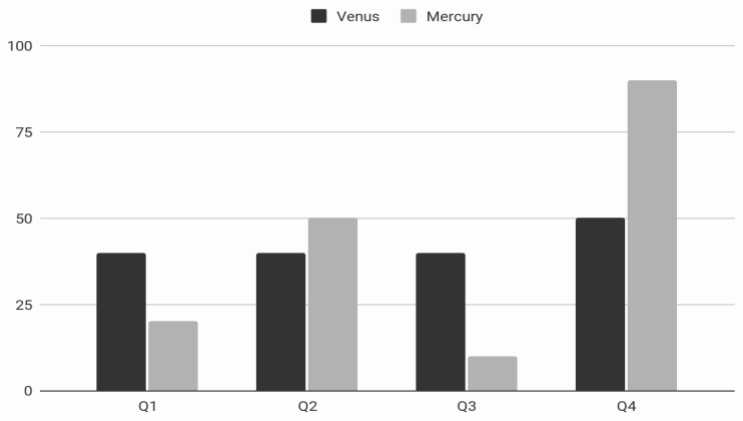
[picture p86: figure]

Follow the link in the graph to modify its data and then paste the new one here. For more info, click here (https://slidesgo.com/slidesgo-school/presentation-tips/how-to-modify-a-graph-in-our-templates)

## Venus

Venus has a
beautiful name

## Mercury

Mercury is quite a
small planet

Mercury is the closest planet to the Sun and the smallest one in the Solar System The planet’s name has nothing to do with the liquid metal

- The Sun is the star at the center of the Solar System
- Jupiter is the biggest planet in the entire Solar System
- Saturn is composed mostly of hydrogen and helium

# Analysis of the results

## Mercury

Mercury is quite a
small planet

## Venus

Venus has a
beautiful name

## Mars

Despite being red,
Mars is a planet very
cold

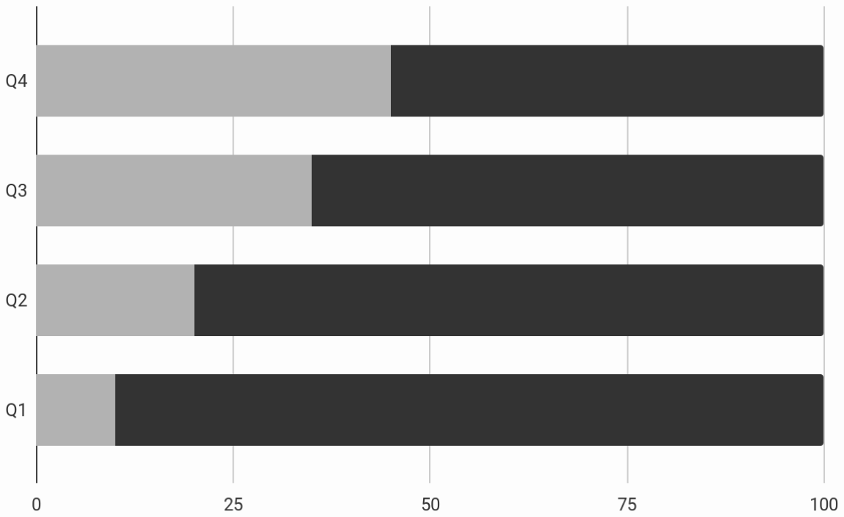
[picture p87: figure]

Follow the link in the graph to modify its data and then paste the new one here. For more info, click here (https://slidesgo.com/slidesgo-school/presentation-tips/how-to-modify-a-graph-in-our-templates)

50%

# This is a map

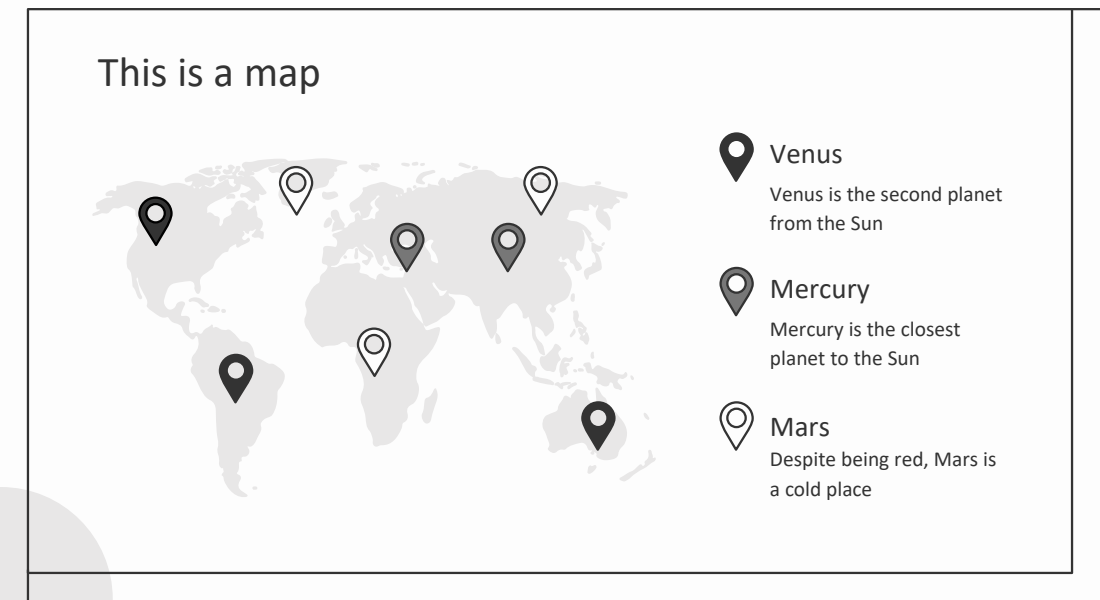
[picture p88: page 58]
Venus; Mercury

Venus is the second planet
from the Sun

Mercury is the closest
planet to the Sun

Mars
Despite being red, Mars is
a cold place

# Discussion

Despite being red, Mars is actually a cold place. It's full of iron oxide dust, which gives the planet its reddish cast. Earth is the third planet from the Sun and the only one that harbors life in the Solar System. This is where we all live:

- Ceres is located in the main asteroid belt
- The Moon is Earth’s natural satellite
- Neptune is very far away from us
- Pluto is now considered a dwarf planet

## Mars & Earth Discussion 1

Mercury is the closest planet to the Sun and the smallest one in the Solar System. It’s bit larger than the Moon

## Discussion 2

Venus has a beautiful name and is the second planet from the Sun. Venus is a lot hotter than
Mercury

# Conclusions

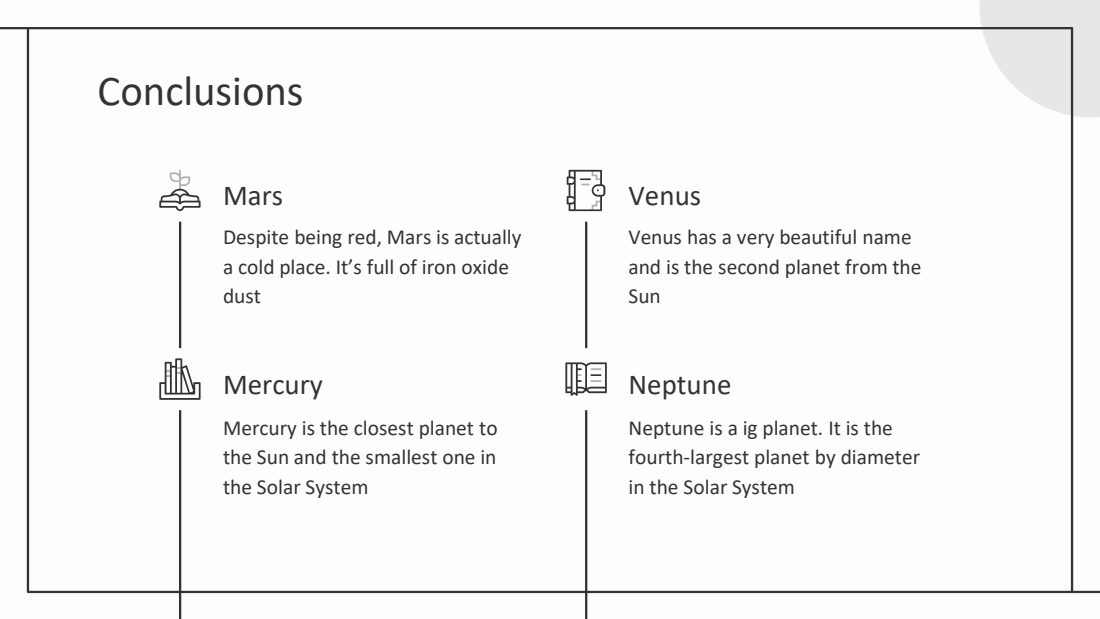
[picture p89: page 60]
Mars; Venus; Mercury; Neptune

Despite being red, Mars is actually
a cold place. It’s full of iron oxide
dust

Venus has a very beautiful name
and is the second planet from the
Sun

Mercury is the closest planet to
the Sun and the smallest one in
the Solar System

Neptune is a ig planet. It is the
fourth-largest planet by diameter
in the Solar System

# Bibliographical references

Surname, A. (YEAR). Name of the source. Publisher Surname, A. (YEAR). Name of the source. Publisher Surname, A. (YEAR). Name of the source. Publisher Surname, A. (YEAR). Name of the source. Publisher Surname, A. (YEAR). Name of the source. Publisher Surname, A. (YEAR). Name of the source. Publisher Surname, A. (YEAR). Name of the source. Publisher Surname, A. (YEAR). Name of the source. Publisher Surname, A. (YEAR). Name of the source. Publisher Surname, A. (YEAR). Name of the source. Publisher

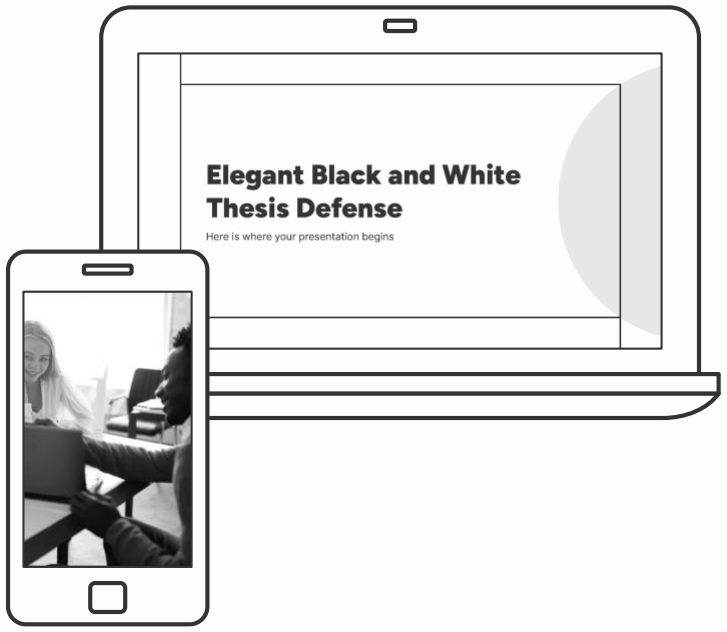
[picture p90: figure]

# Mockups

You can replace the images on the screen with your own work. Just right-click on them and select “Replace image”

# Icon pack

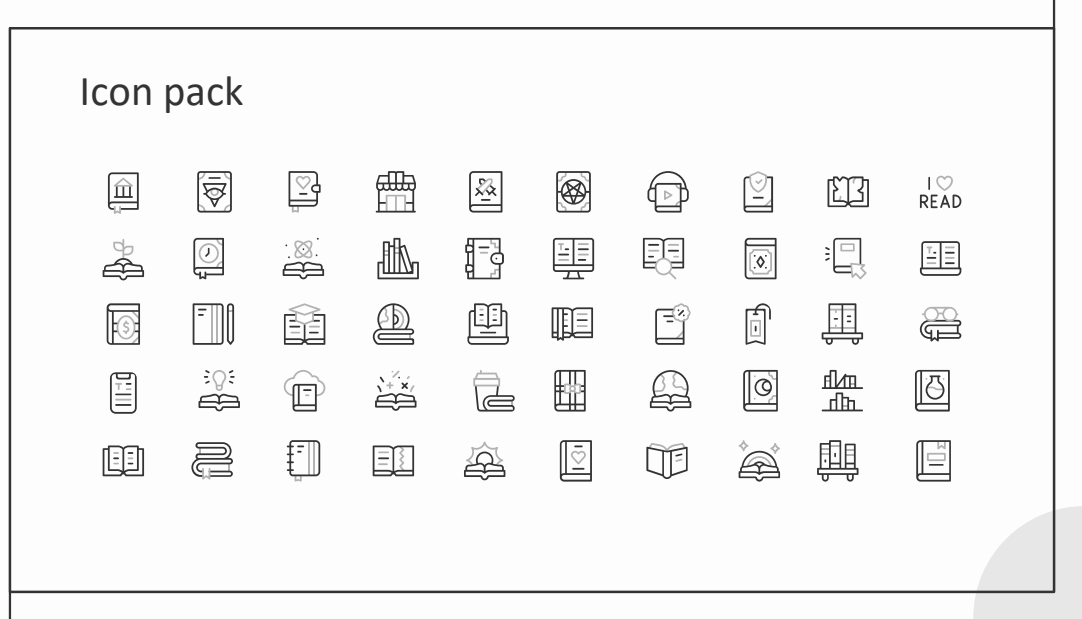
[picture p91: page 63]

# Alternative resources

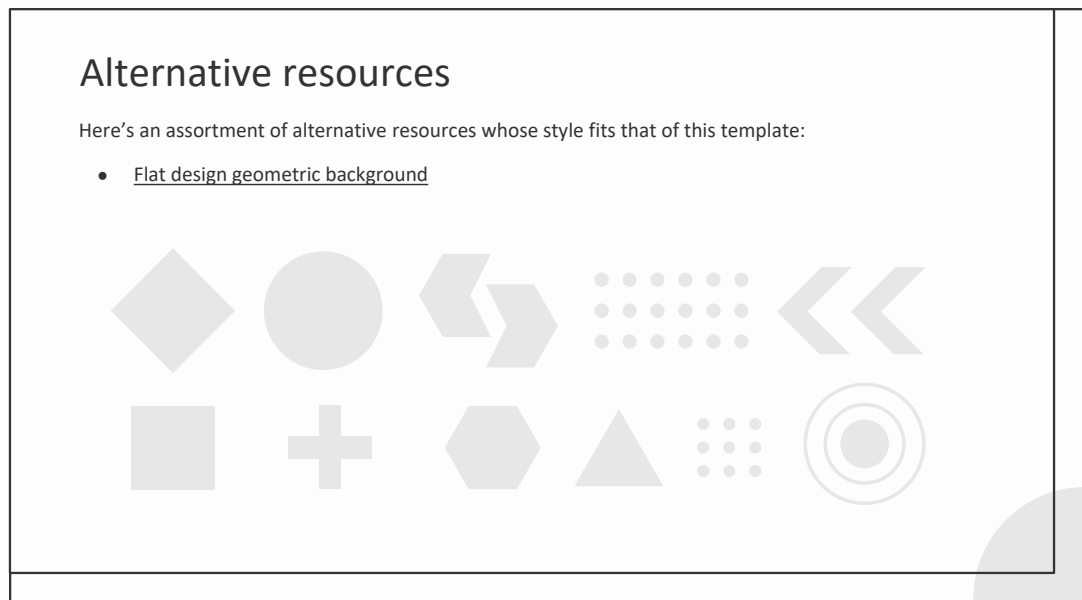
[picture p92: page 64]

Here’s an assortment of alternative resources whose style fits that of this template:

● Flat design geometric background (https://www.freepik.com/free-vector/flat-design-geometric-background_13657882.htm/)

# Resources

Did you like the resources in this template? Get them at these websites:

Icons
- Icon Pack: Books | Outline (https://www.flaticon.com/packs/books-64?word=study/?utm_source=slidesgo_template)

Photos
- Medium shot people at traveling agency (https://www.freepik.com/free-photo/medium-shot-people-traveling-agency_17806291.htm/)
- Close up hand signing document (https://www.freepik.com/free-photo/close-up-hand-signing-document_17806334.htm/)

## Instructions for use

If you have a free account, in order to use this template, you must credit Slidesgo (http://bit.ly/2PfT4lq) by keeping the Thanks slide. Please refer to the next slide to read the instructions for premium users.

As a Free user, you are allowed to:
- Modify this template.
- Use it for both personal and commercial projects.

You are not allowed to:
- Sublicense, sell or rent any of Slidesgo Content (or a modified version of Slidesgo Content).
- Distribute Slidesgo Content unless it has been expressly authorized by Slidesgo.
- Include Slidesgo Content in an online or offline database or file.
- Offer Slidesgo templates (or modified versions of Slidesgo templates) for download.
- Acquire the copyright of Slidesgo Content.

For more information about editing slides, please read our FAQs or visit our blog: https://slidesgo.com/faqs (http://bit.ly/33VAFh3) and https://slidesgo.com/slidesgo-school (http://bit.ly/30B07Gq)

As a Premium user, you can use this template without attributing Slidesgo (http://bit.ly/2PfT4lq) or keeping the "Thanks" slide.

You are allowed to:
- Modify this template.
- Use it for both personal and commercial purposes.
- Hide or delete the “Thanks” slide and the mention to Slidesgo in the credits.
- Share this template in an editable format with people who are not part of your team.

You are not allowed to:
- Sublicense, sell or rent this Slidesgo Template (or a modified version of this Slidesgo Template).
- Distribute this Slidesgo Template (or a modified version of this Slidesgo Template) or include it in a database or in any other product or service that offers downloadable images, icons or presentations that may be subject to distribution or resale.
- Use any of the elements that are part of this Slidesgo Template in an isolated and separated way from this Template.
- Register any of the elements that are part of this template as a trademark or logo, or register it as a work in an intellectual property registry or similar.

For more information about editing slides, please read our FAQs or visit our blog: https://slidesgo.com/faqs (http://bit.ly/33VAFh3) and https://slidesgo.com/slidesgo-school (http://bit.ly/30B07Gq)

## Instructions for use (premium users)

This presentation has been made using the following fonts:

Figtree
(https://fonts.google.com/specimen/Figtree)

Hanken Grotesk
(https://fonts.google.com/specimen/Hanken+Grotesk)

## Fonts & colors used

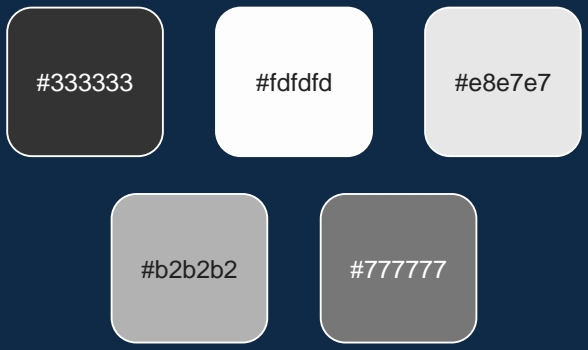
[picture p93: figure]
#fdfdfd

Create your Story with our illustrated concepts. Choose the style you like the most, edit its colors, pick the background and layers you want to show and bring them to life with the animator panel! It will boost your presentation. Check out how it works. (https://storyset.com/how-it-works)

## Storyset

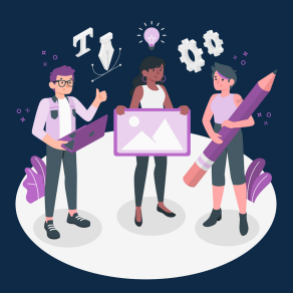
[picture p94: figure]
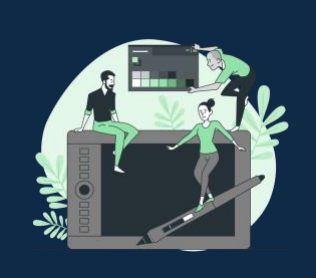
[picture p95: figure]
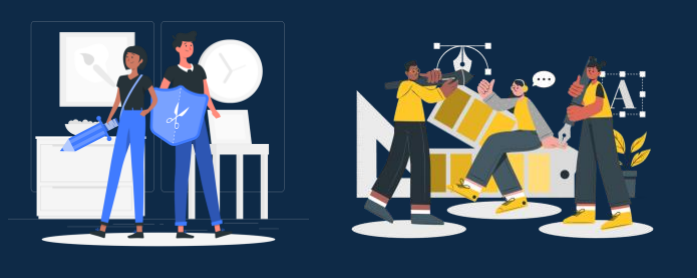
[picture p96: figure]
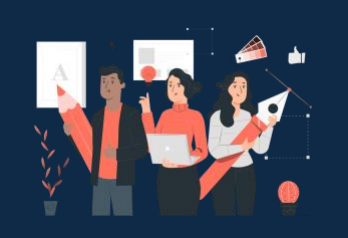
[picture p97: figure]

Pana (https://storyset.com/pana) | Amico (https://storyset.com/amico) | Bro (https://storyset.com/bro) | Rafiki (https://storyset.com/rafiki) | Cuate (https://storyset.com/cuate)

You can easily resize these resources without losing quality. To change the color, just ungroup the resource and click on the object you want to change. Then, click on the paint bucket and select the color you want. Group the resource again when you’re done. You can also look for more infographics (https://bit.ly/2ZjL1pd) on Slidesgo.

Use our editable graphic resources...

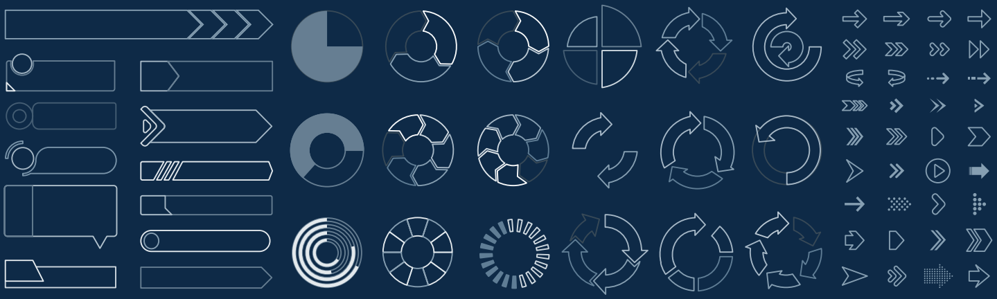
[picture p98: figure]
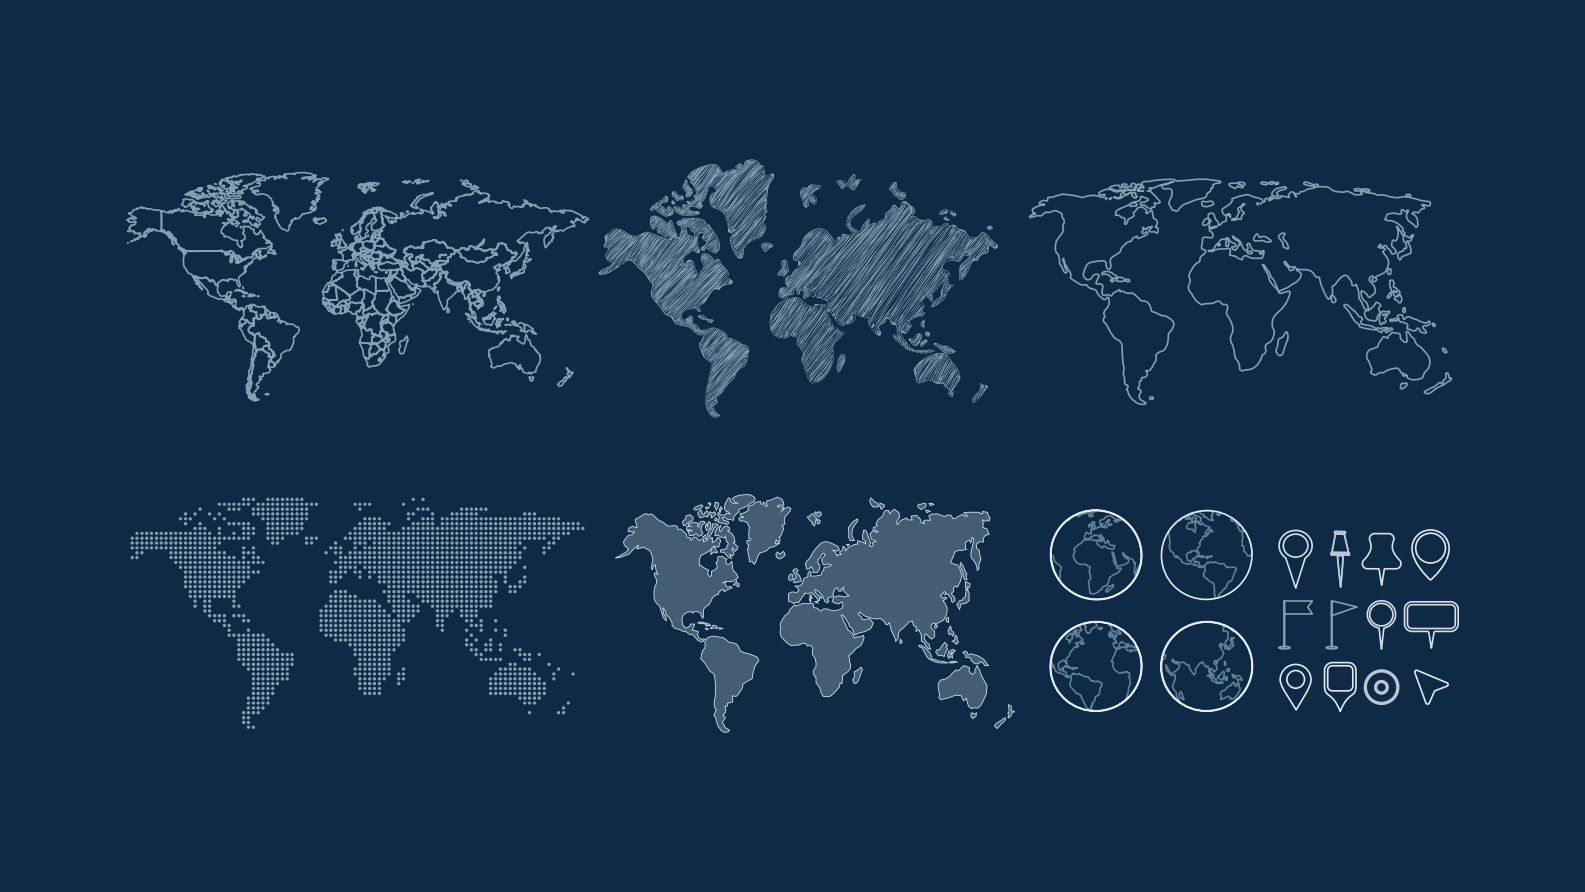
[picture p99: page 71]

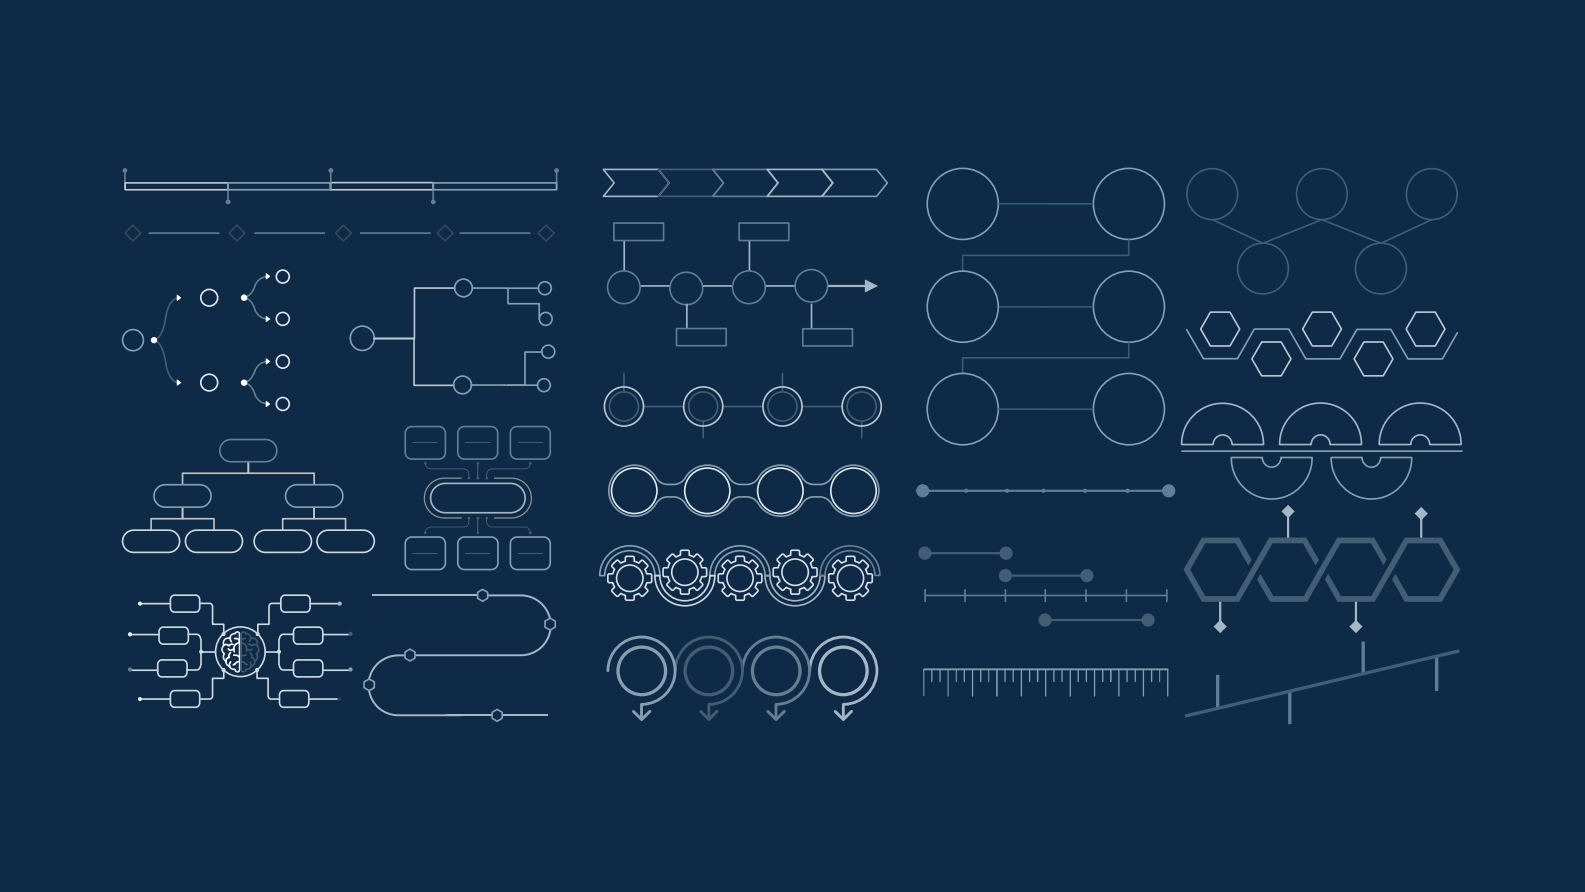
[picture p100: page 72]

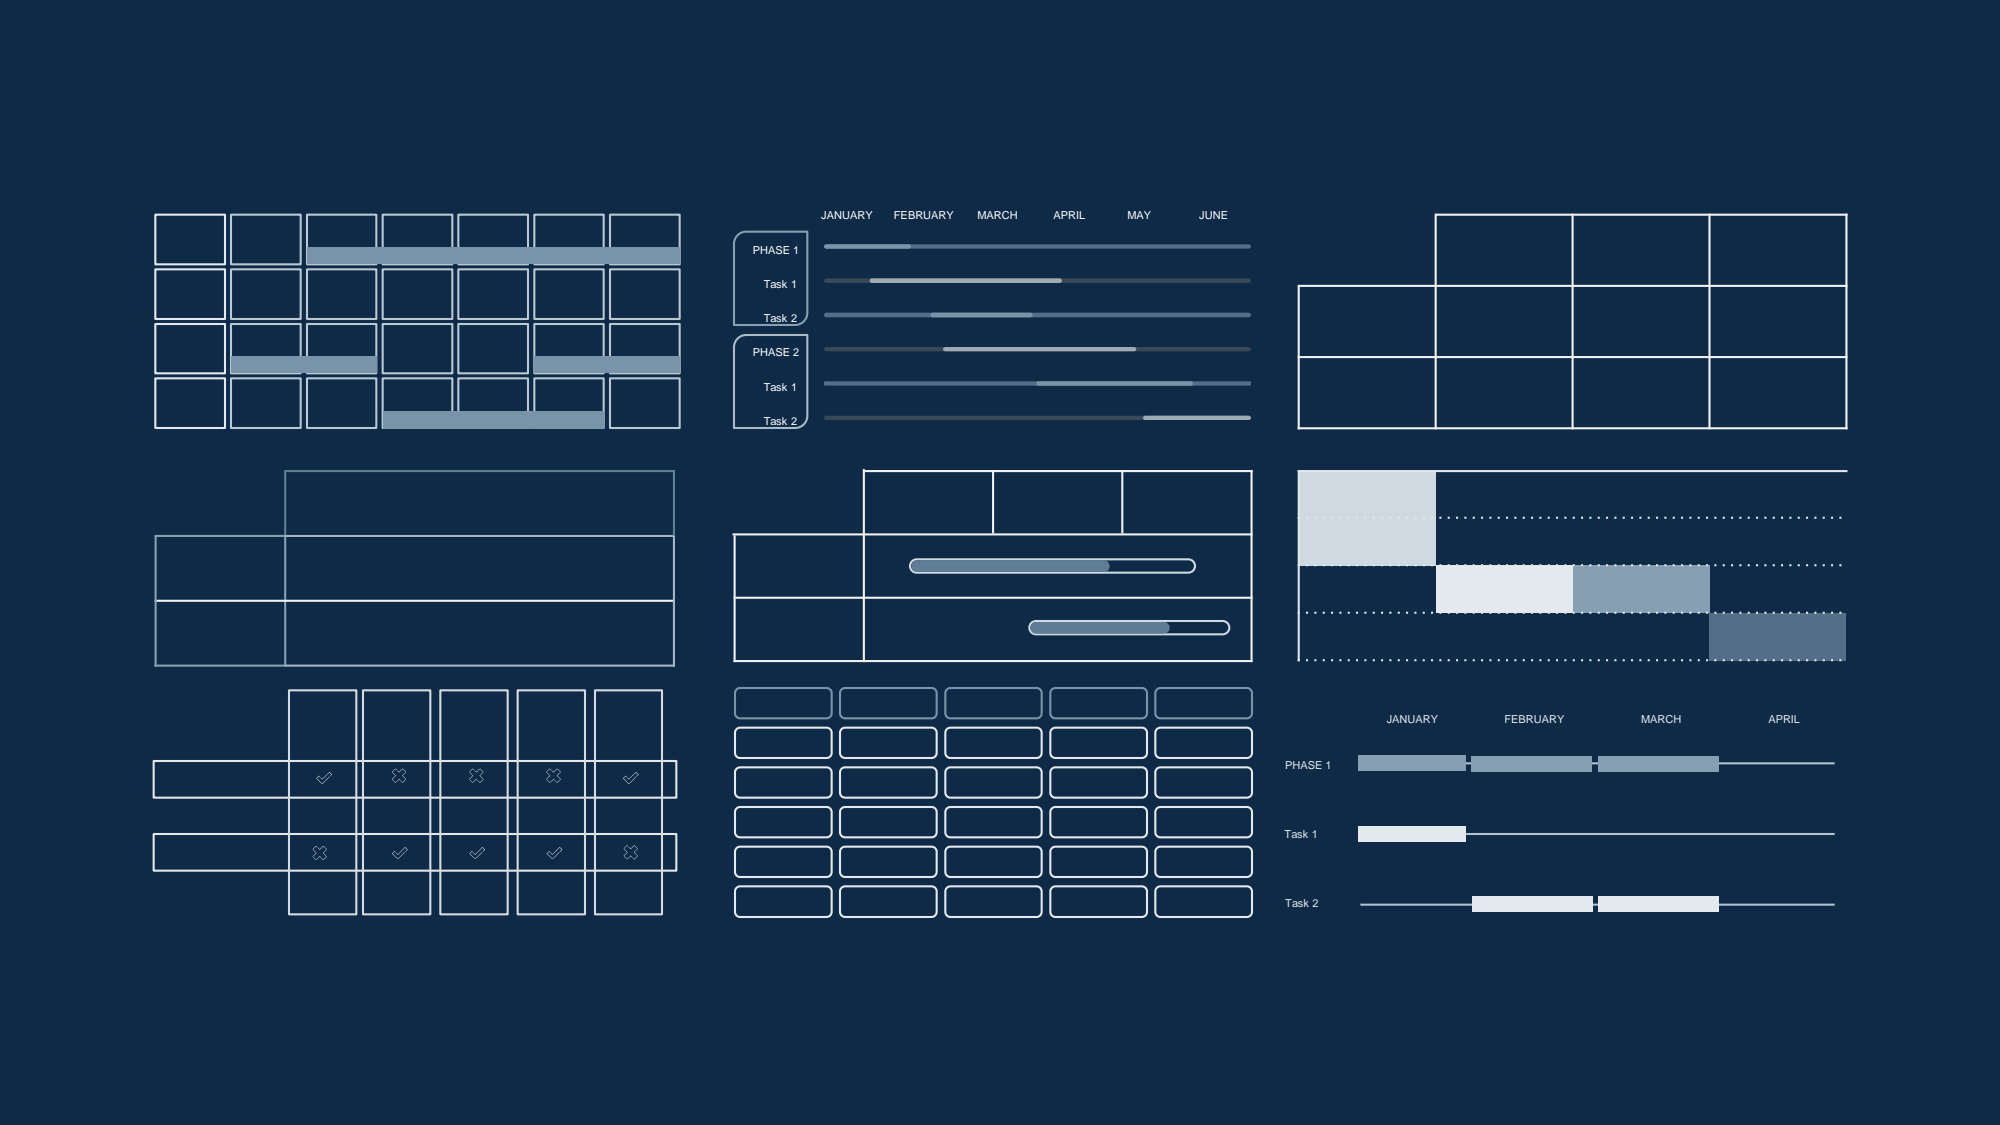
[picture p101: page 73]
JANUARY; FEBRUARY; MARCH; APRIL; PHASE 1; Task 1; Task 2; MAY; JUNE; PHASE 2

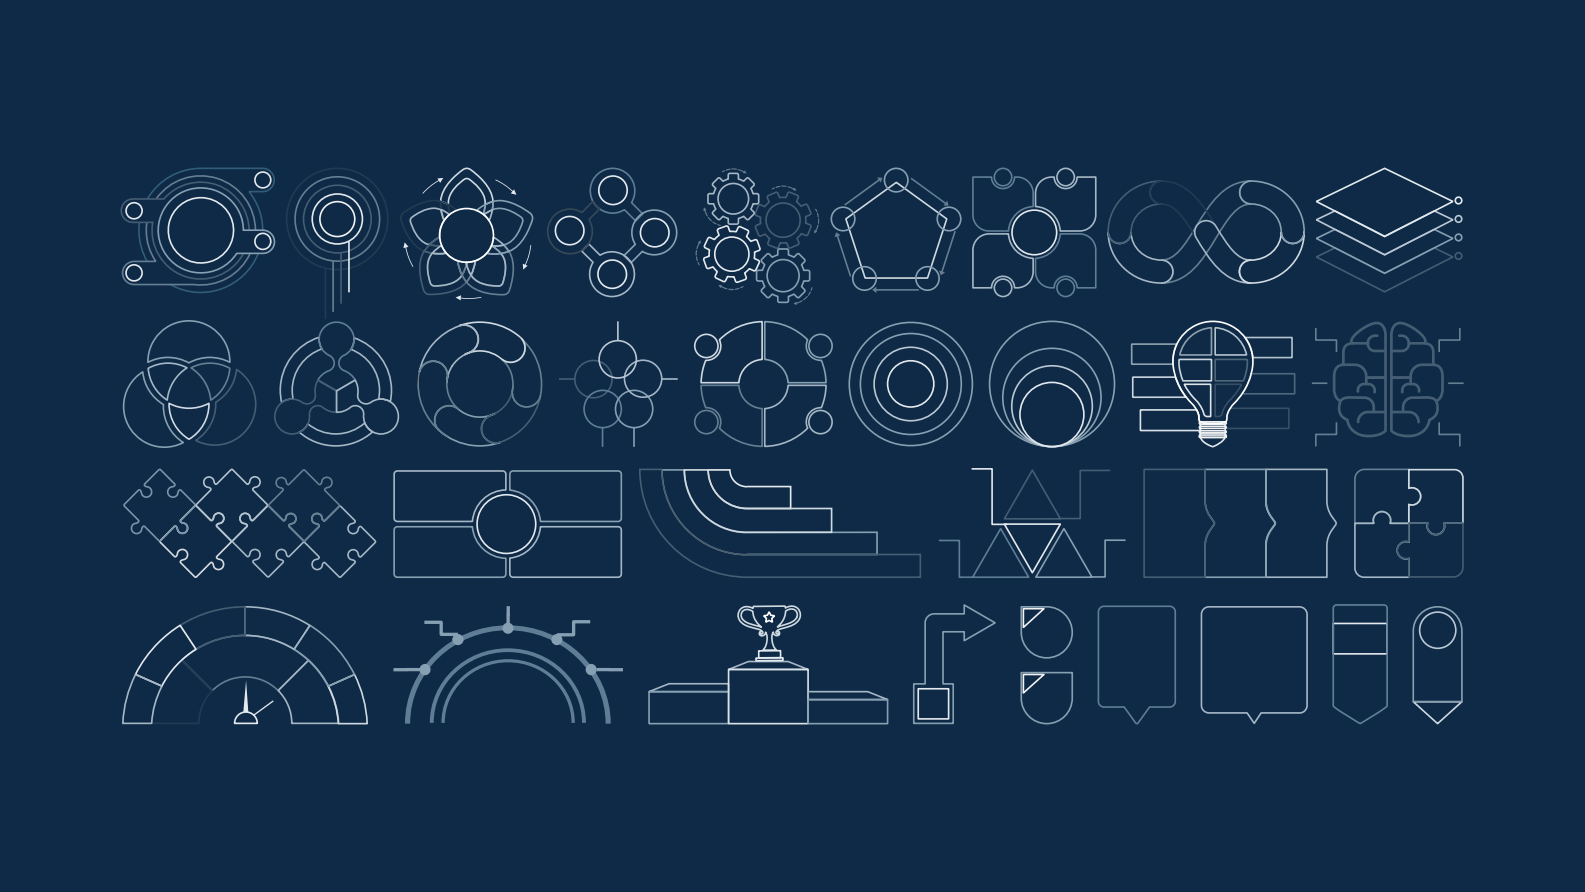
[picture p102: page 74]

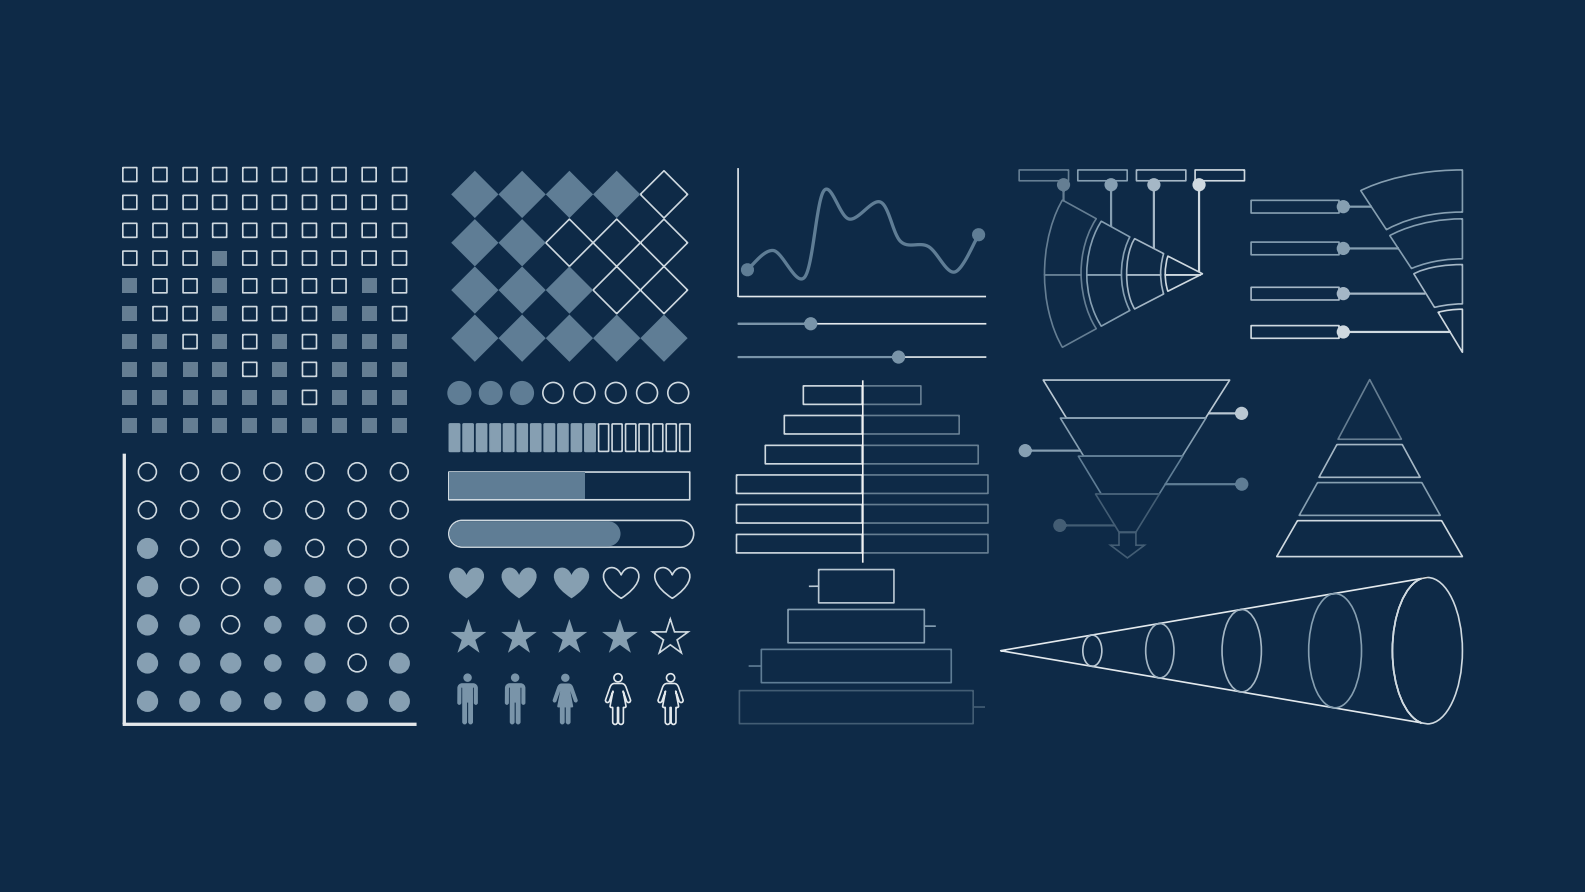
[picture p103: page 75]

## ...and our sets of editable icons

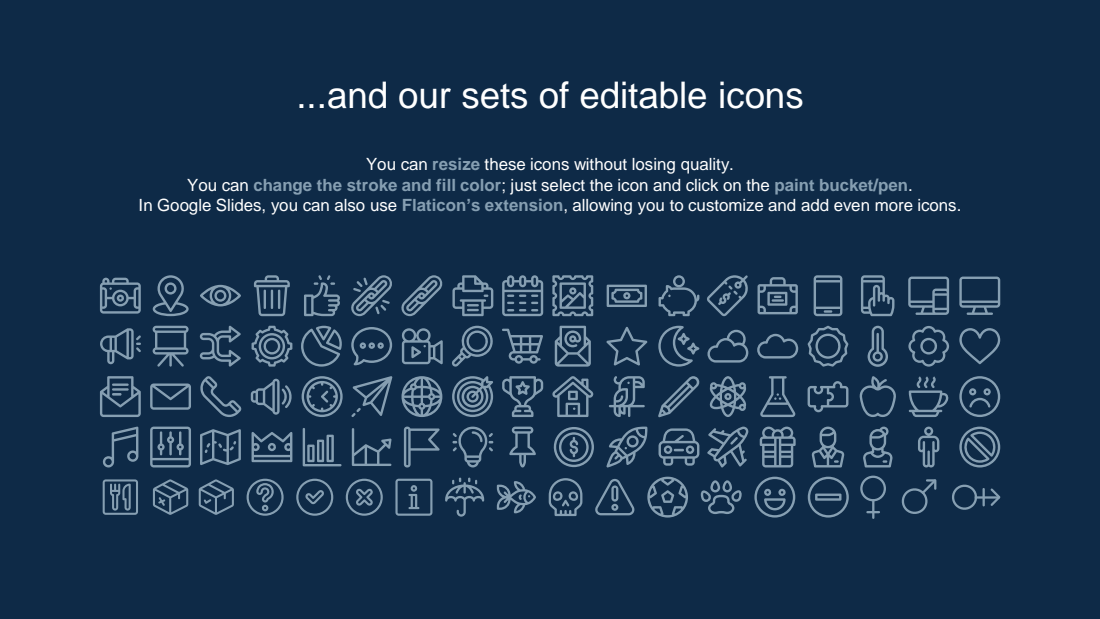
[picture p104: page 76]

You can resize these icons without losing quality.

You can change the stroke and fill color; just select the icon and click on the paint bucket/pen.

In Google Slides, you can also use Flaticon’s extension, (https://workspace.google.com/marketplace/app/icons_for_slides_docs/381578326502) allowing you to customize and add even more icons.

Educational Icons | Medical Icons

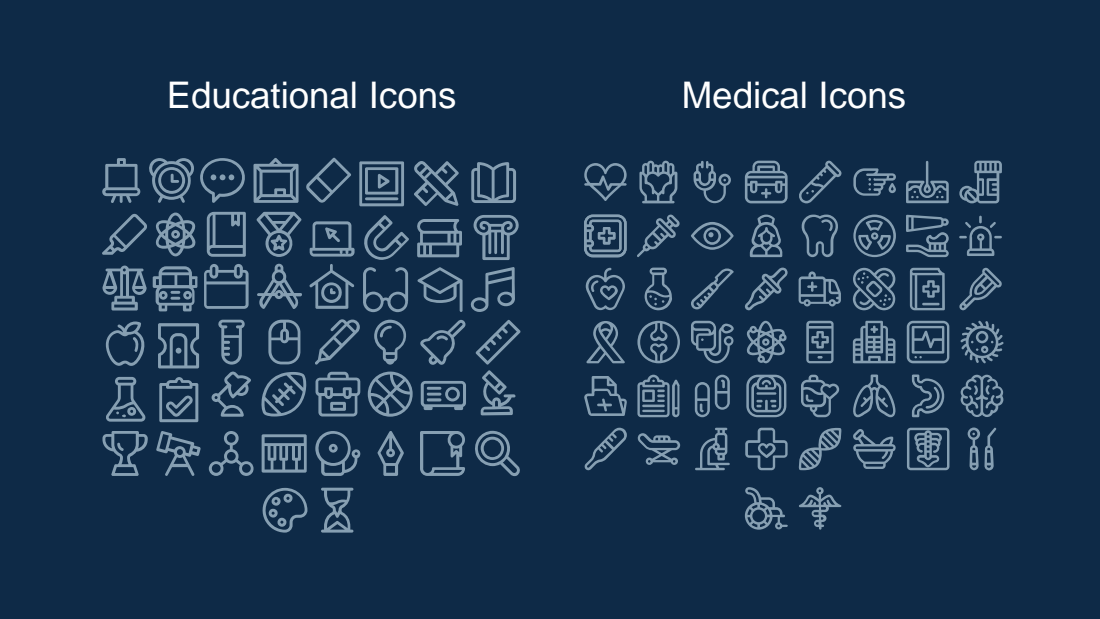
[picture p105: page 77]

Business Icons | Teamwork Icons

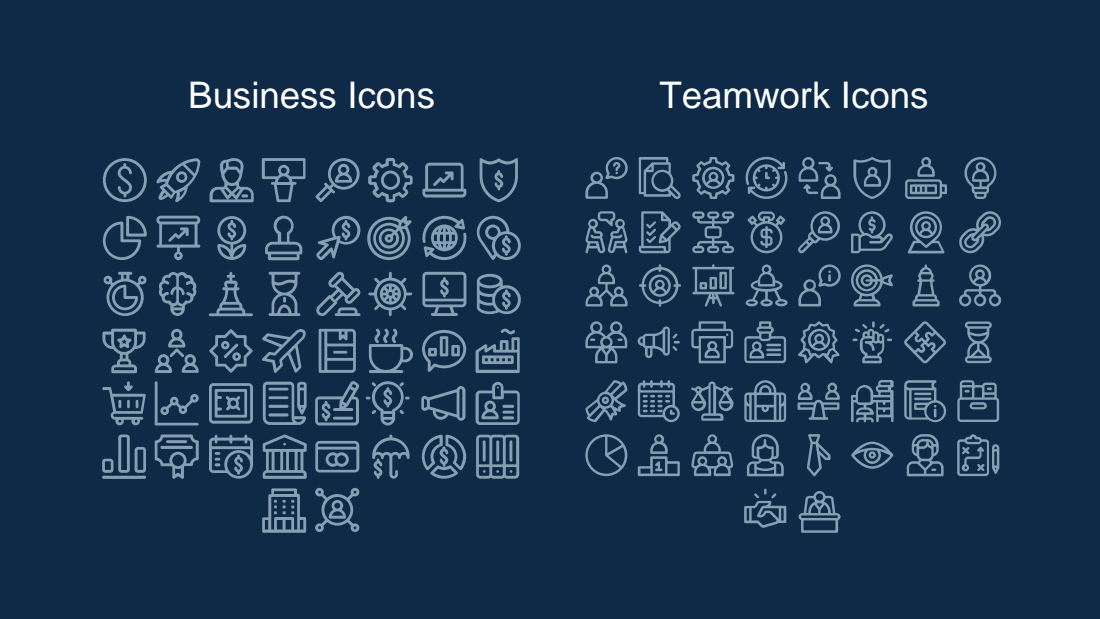
[picture p106: page 78]

Help & Support Icons | Avatar Icons

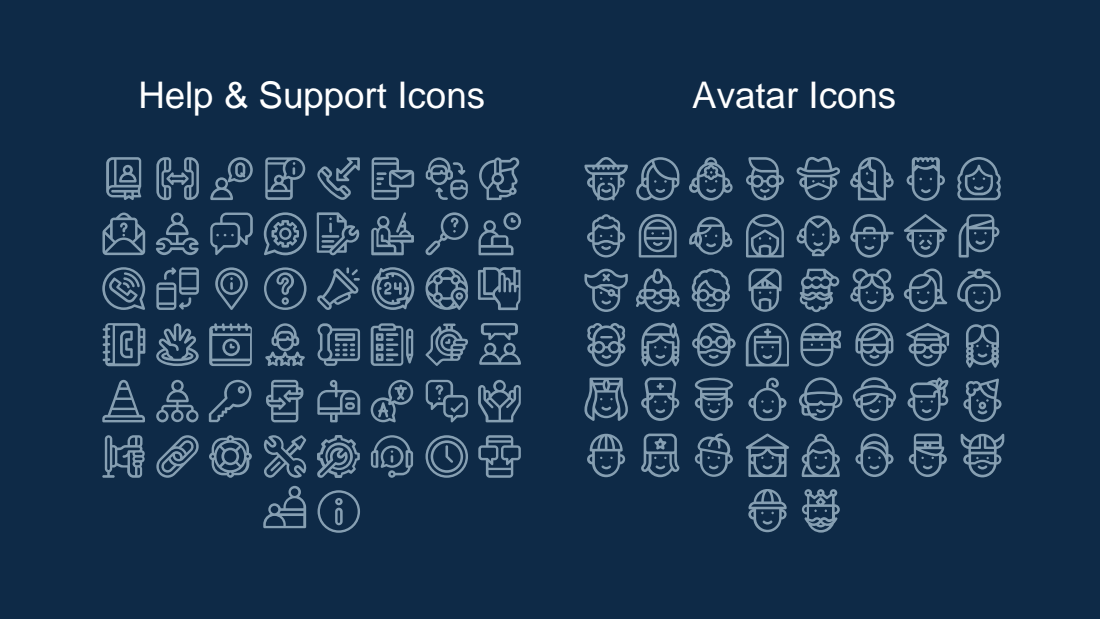
[picture p107: page 79]

Creative Process Icons | Performing Arts Icons

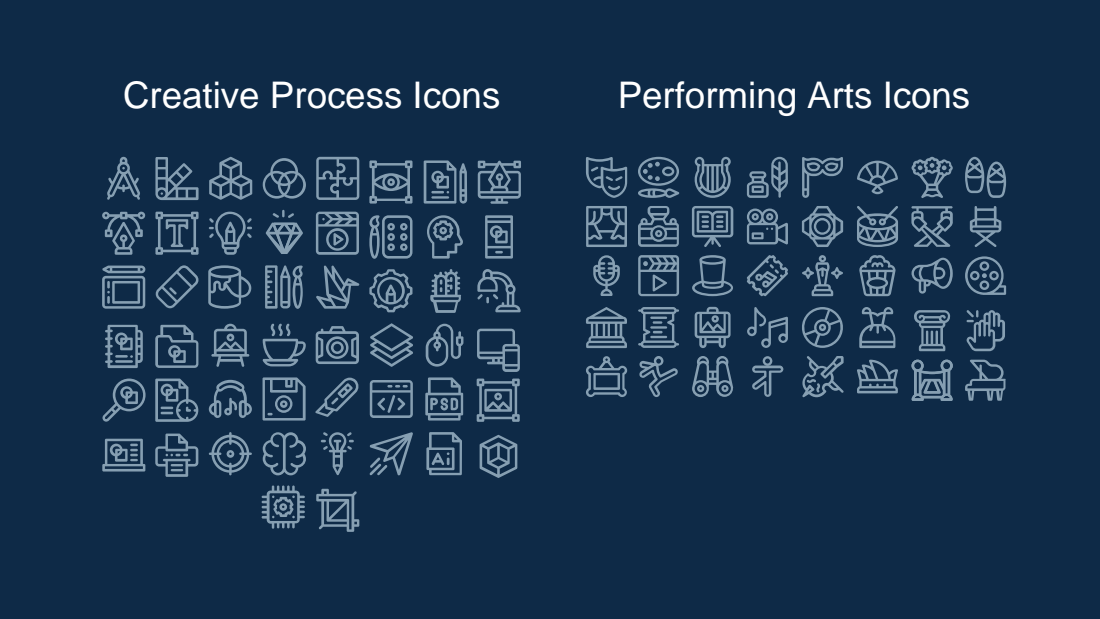
[picture p108: page 80]

## Nature Icons

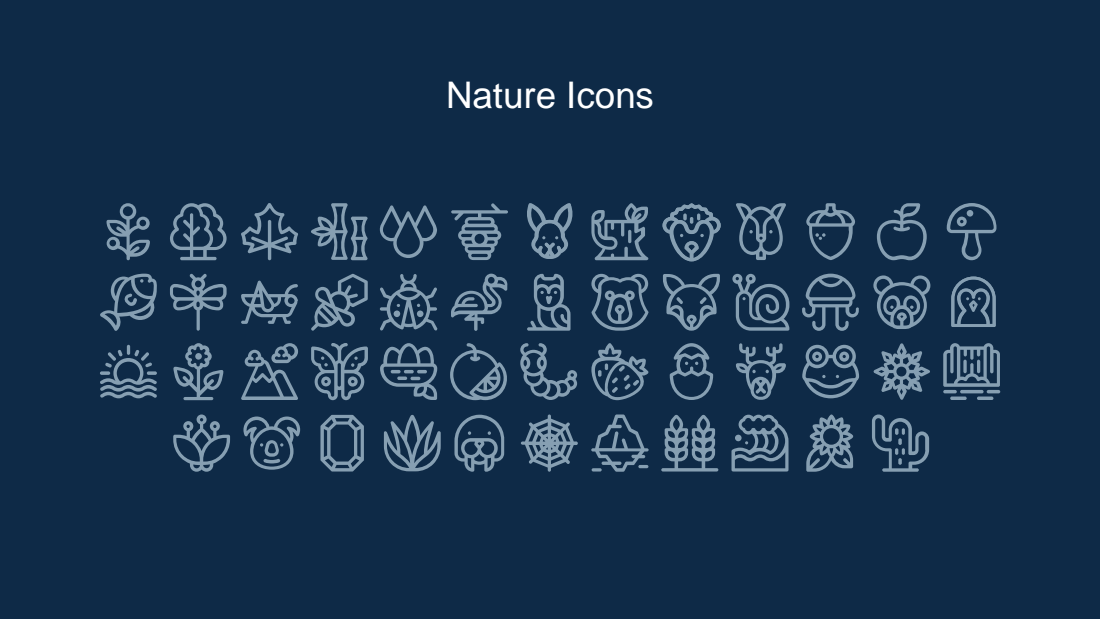
[picture p109: page 81]

## SEO & Marketing Icons

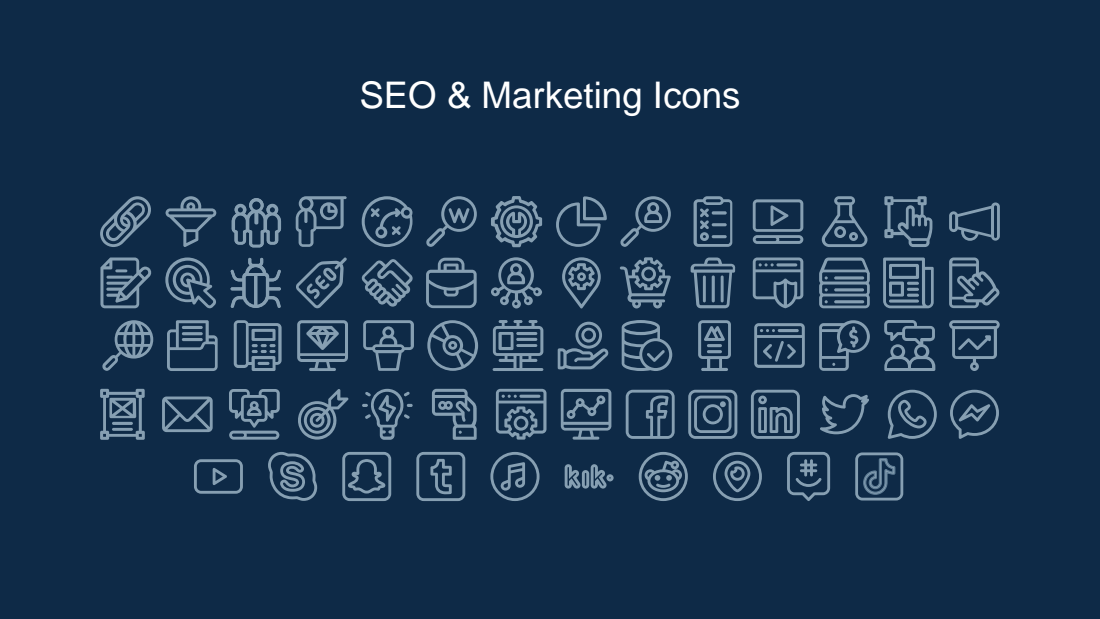
[picture p110: page 82]

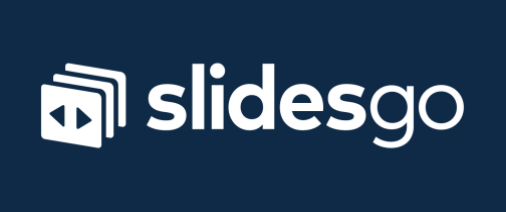
[picture p111: figure]
