mbeayou/Ball-and-Plate-Balancing-System/Assets/photo_2024-01-09_19-24-37.jpg

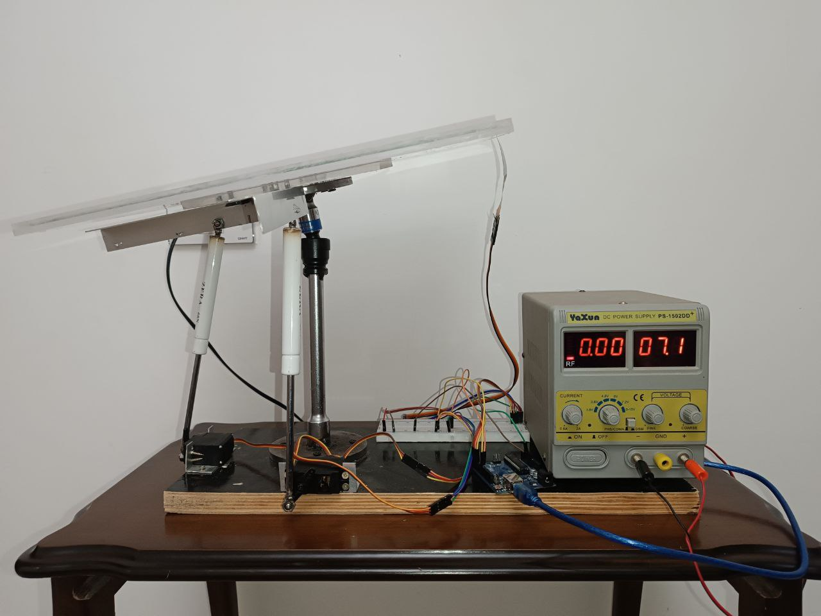
Assets/photo_2024-01-09_19-24-37.jpg
