mbeayou/Ball-and-Plate-Balancing-System/Documentation/Dissertation/Latex files/Figures/chapter02/carbon(3).png

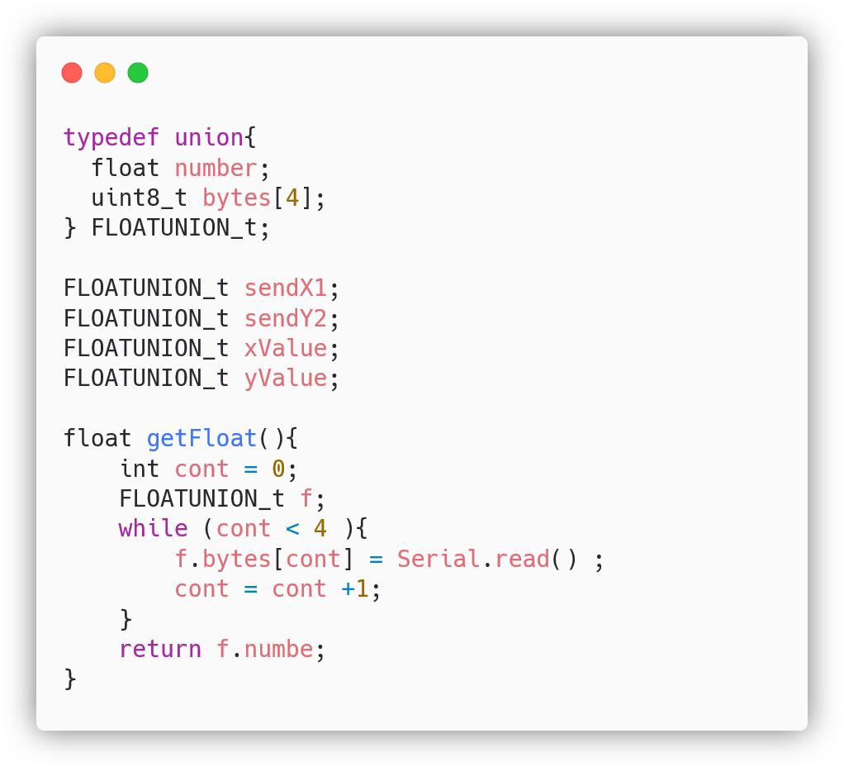
Documentation/Dissertation/Latex files/Figures/chapter02/carbon(3).png
