mbeayou/Ball-and-Plate-Balancing-System/Documentation/Dissertation/Latex files/Figures/chapter03/NonLinear_BPS_Simulink_Model_inStateSpace.jpg

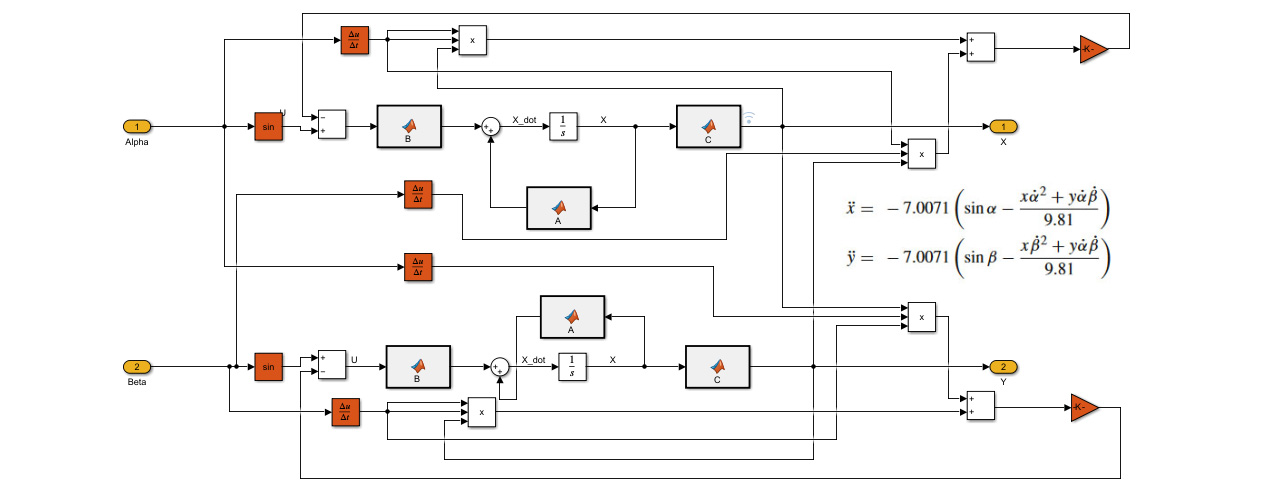
Documentation/Dissertation/Latex files/Figures/chapter03/NonLinear_BPS_Simulink_Model_inStateSpace.jpg
