mbeayou/Ball-and-Plate-Balancing-System/Documentation/Dissertation/Latex files/Figures/chapter03/Open_loop_BPS_linear_and_nonlinear_comparsion_vertical.png

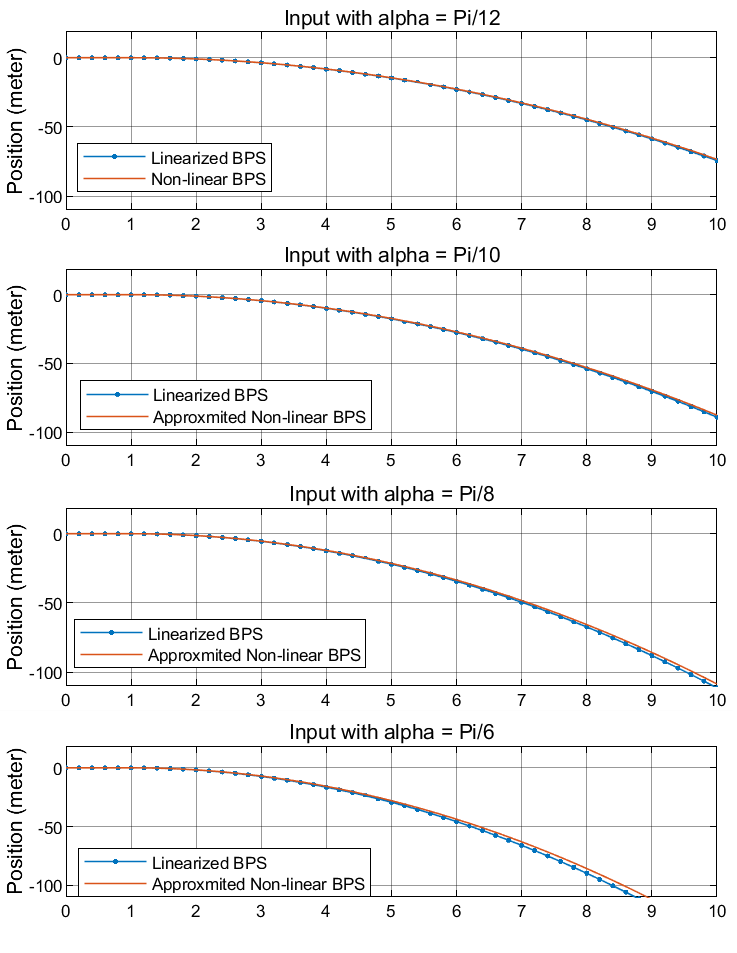
Documentation/Dissertation/Latex files/Figures/chapter03/Open_loop_BPS_linear_and_nonlinear_comparsion_vertical.png
