mbeayou/Ball-and-Plate-Balancing-System/Documentation/Dissertation/Latex files/Figures/chapter03/Simscape_Model.jpg

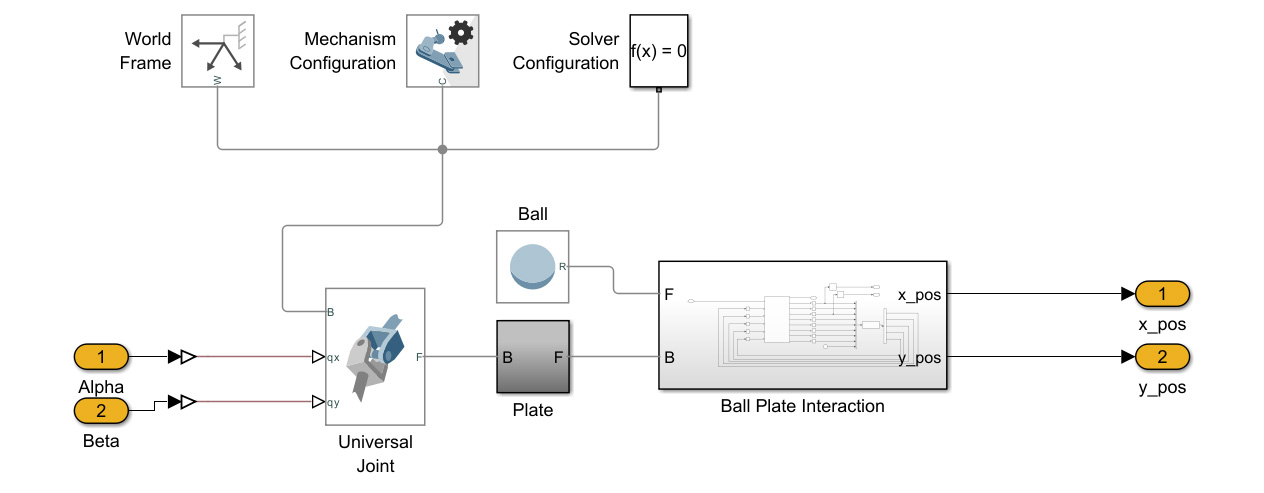
Documentation/Dissertation/Latex files/Figures/chapter03/Simscape_Model.jpg
