mbeayou/Ball-and-Plate-Balancing-System/Documentation/Dissertation/Latex files/Figures/chapter03/SolidBallSegments.jpeg

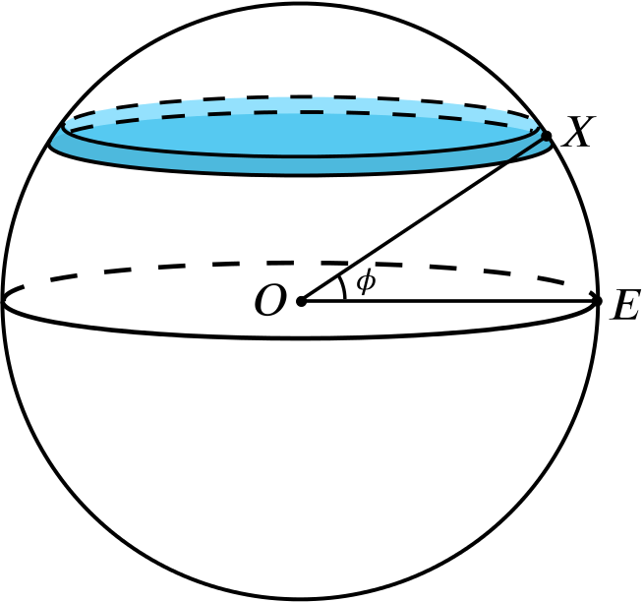
Documentation/Dissertation/Latex files/Figures/chapter03/SolidBallSegments.jpeg
