mbeayou/Ball-and-Plate-Balancing-System/Documentation/Dissertation/Latex files/Figures/chapter04/ideal_pid_simulink.png.png

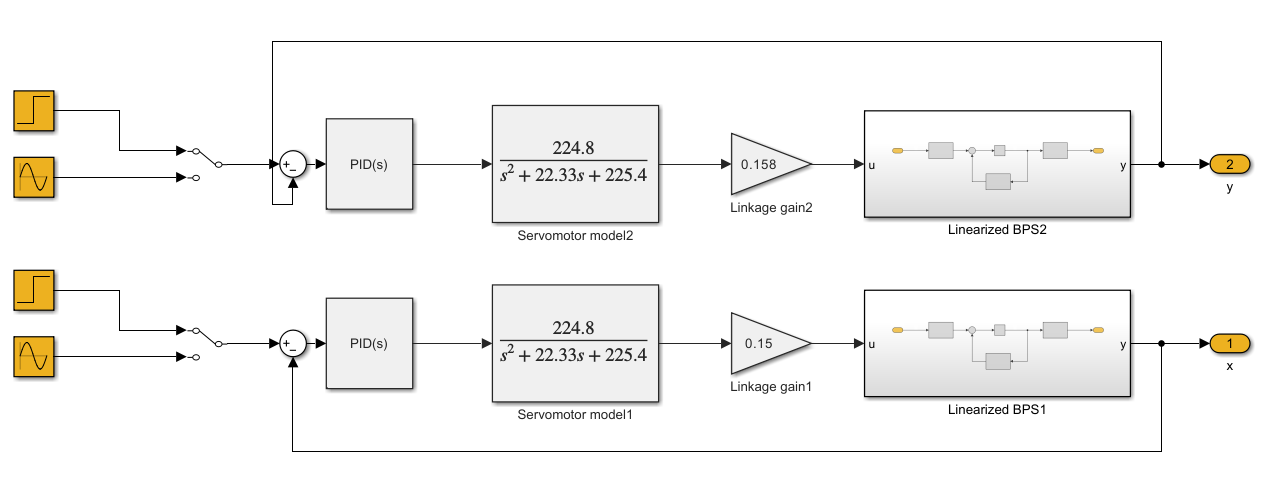
Documentation/Dissertation/Latex files/Figures/chapter04/ideal_pid_simulink.png.png
