mbeayou/Ball-and-Plate-Balancing-System/Documentation/Dissertation/Latex files/Figures/chapter05/Step_trajectory_PID3_Simulation.png

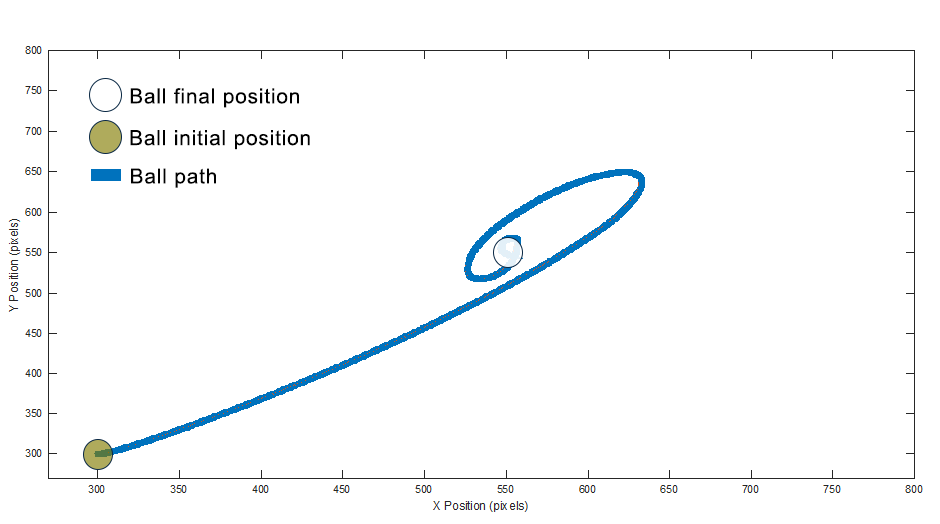
Documentation/Dissertation/Latex files/Figures/chapter05/Step_trajectory_PID3_Simulation.png
