mbeayou/Ball-and-Plate-Balancing-System/Results and plots/Step_response_PID1_Expiremental_half2.png

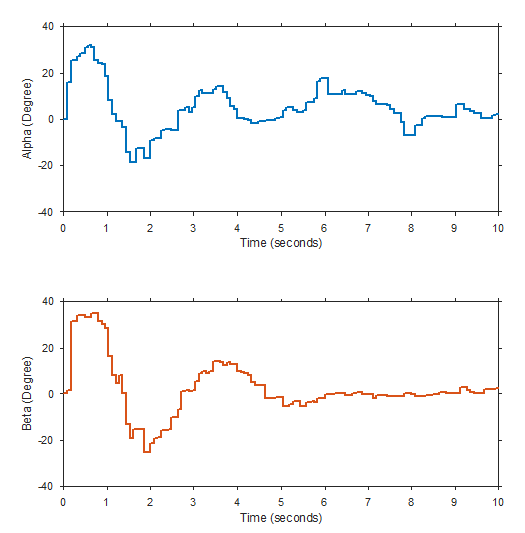
Results and plots/Step_response_PID1_Expiremental_half2.png
